EduGomesNascimento/VOASUL/drone/cad/molde_compensado.pdf

## Frame do drone VoaSul em compensado 3 mm: MOLDE 1:1

Linha cheia = corte | tracejado = referencia de colagem | cruz = centro do furo

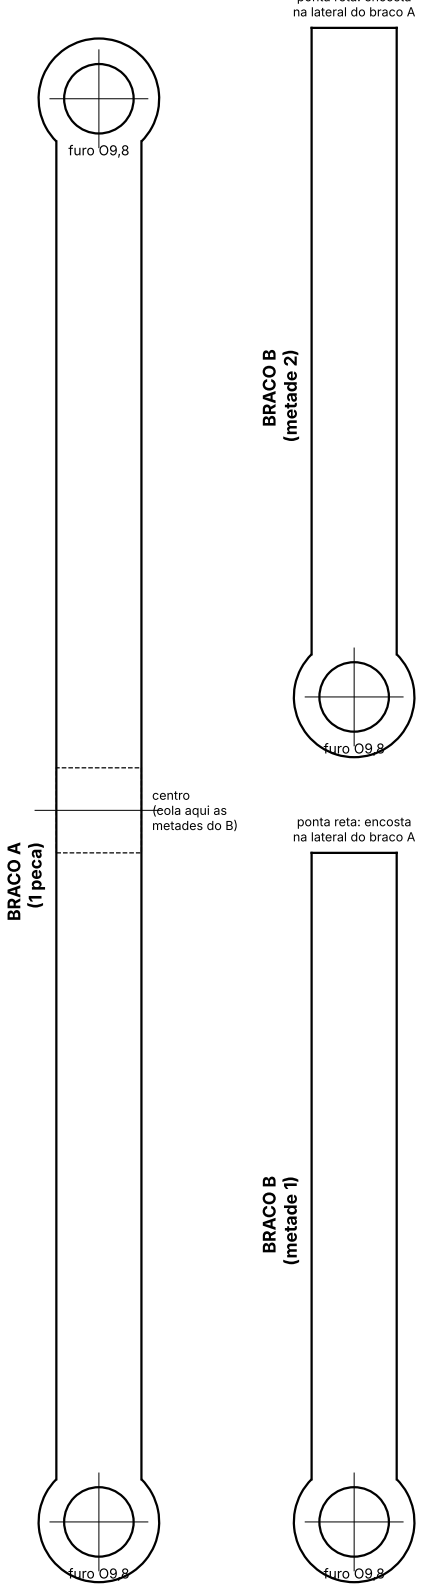
[picture p6: figure]
furo O9,8; centro (cola aqui as metades do B); BRACO A; (1 peca); ponta reta: encosta na lateral do braco A; BRACO B (metade 1); na lateral do braco A; BRACO B (metade 2)

0 | 50 | 100

REGUA 100 mm: confira com uma regua antes de cortar (impressao em 100%, sem "ajustar")

furo O9,8

ponta reta: encosta

FRENTE

PLACA DO CENTRO (cima)

FRENTE

PLACA DO CENTRO (baixo)

Chapa: compensado 3 mm
Peso estimado: ~12 g (+~1 g de cola) PLA atual: ~28 g

Motores a 100,4 mm do centro (diagonal motor-motor 200,8 mm) Furo do motor O9,8: broca de 10 mm e teste; folgado -> volta de fita

Cortar: 1 braco A, 2 metades B,
2 placas do centro
Montagem na pagina 2

# Montagem do frame de compensado

Desenho em ESCALA 1:2 (metade do tamanho real): use as medidas escritas, nao a regua

FRENTE (lado do MT3608 da placa)

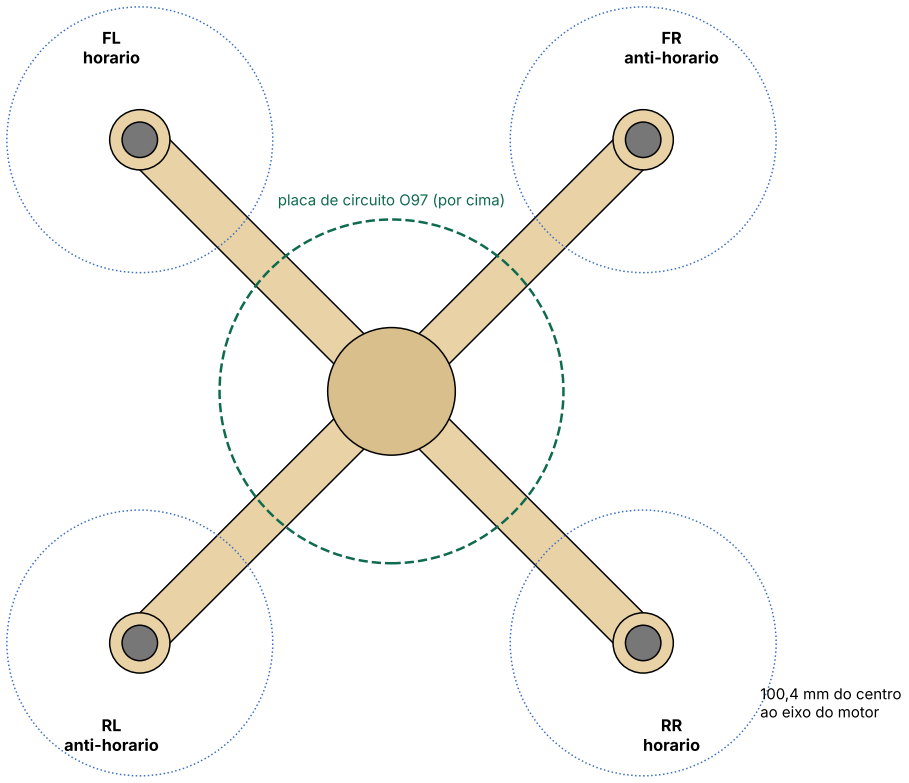
[picture p7: figure]
FR anti-horario; RR horario; RL anti-horario; FL horario; placa de circuito O97 (por cima); 100,4 mm do centro ao eixo do motor

Antes | Imprima a pagina 1 em 100% (A4, sem "ajustar a pagina") e confira a regua de 100 mm. Meca a chapa: o molde e para 3 mm; 4 mm tambem serve, so pesa mais.
1. Molde | Cole o papel na chapa com cola bastao. Fure ANTES de cortar (a peca ainda firme): broca fina de guia na cruz, depois a de 10 mm. Teste o motor: tem que entrar justo.
2. Corte | Serrinha tico-tico ou estilete forte, varias passadas. Corte por FORA da linha e lixe ate ela. As metades do braco B tem a ponta reta em esquadro: ela encosta na lateral do braco A.
3. Colagem | Mesa plana com papel-manteiga. Braco A no meio, as metades do B encostadas nele formando um X a 90 graus (use um esquadro). Cola de madeira ou epoxi na junta e nas duas placas do centro (em cima e embaixo, seguindo o tracejado). Peso em cima ate secar.
4. Conferir | Os 4 motores na MESMA altura e a mesma distancia do centro (diagonais iguais). Frame torto faz o drone girar sozinho.
5. Acabamento | Uma demao fina de verniz ou cola branca diluida: a madeira nao empena com umidade.
6. Motores | Encaixe nos furos (FR e RL anti-horario, RR e FL horario, vistos de cima). Fios por cima do braco com pontos de cola quente.
7. Placa | Sobre a placa do centro de cima, 2 camadas de fita espuma (~3 mm). A placa de circuito fica presa so no centro e SEM encostar nos bracos: embaixo dela, nas diagonais, ha soldas e os MOSFETs. Corte rente as pontas dos pinos embaixo da placa.
8. Bateria e pes | Bateria embaixo do cruzamento, com o velcro em volta do braco A. Pes: 4 pedacos de EVA ou espuma embaixo dos bracos, ~15 mm antes de cada motor.
