EduGomesNascimento/VOASUL/drone/kicad/saidas/folha_transferencia_A4.pdf

BC
COPIA 1

BC
COPIA 2

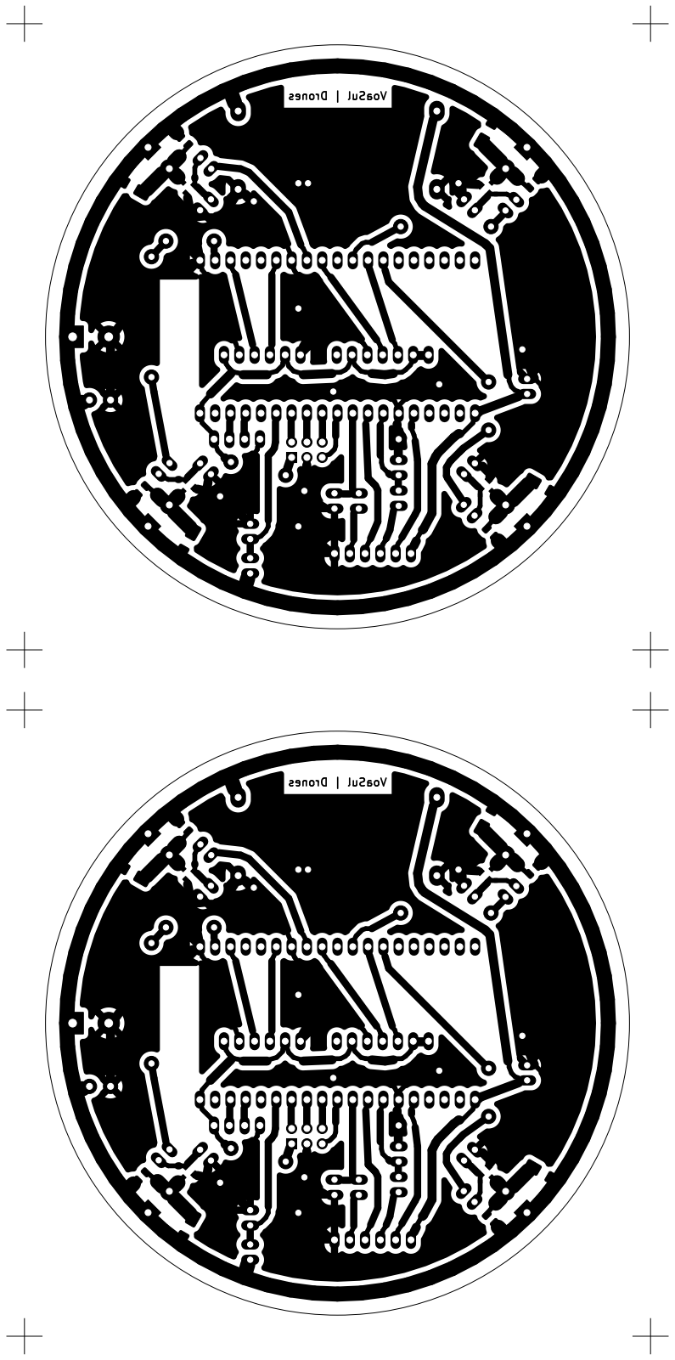
[picture p8: figure]

REGUA 100 mm - meca antes de passar o ferro (tem que dar 100 mm exatos)

DRONE VoaSul - folha de transferencia termica - cobre de baixo (face unica), 1:1
1) Impressora LASER, papel glossy/transferencia, escala 100% (desligue "ajustar a pagina").
2) NAO espelhe: o texto "VoaSul | Drones" da placa aparece AO CONTRARIO no papel - esta certo.
3) Toner virado para o cobre; ferro no algodao, 3-5 min apertando; agua 10 min; tire o papel.
4) Duas copias: use a 2a se a 1a falhar. Furos: 0,9 pinos | 1,0 motor/modulos | 1,3 bateria.
