EduGomesNascimento/VOASUL/drone/cad/frame_redondo.png

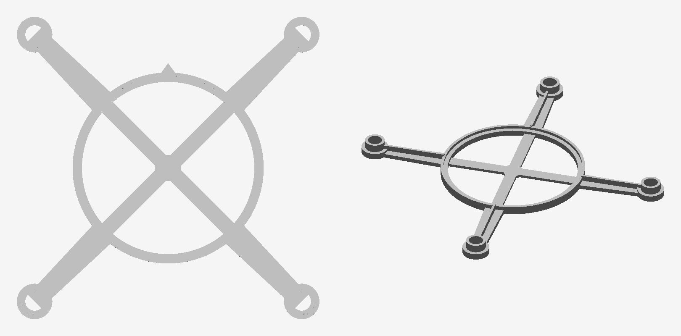
drone/cad/frame_redondo.png
