EduGomesNascimento/VOASUL/drone/docs/esquema.png

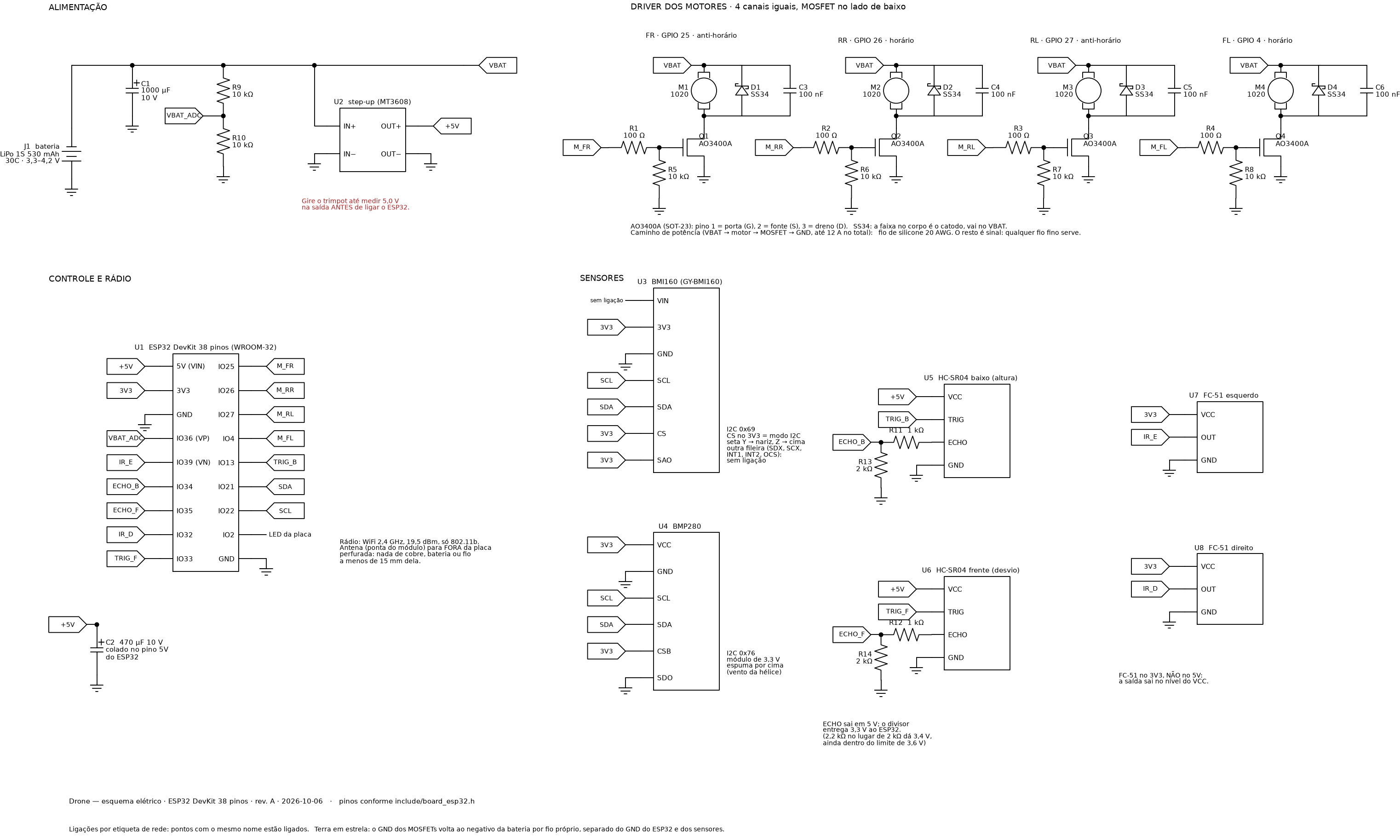
drone/docs/esquema.png
