EduGomesNascimento/VOASUL/drone/docs/layout_placa.png

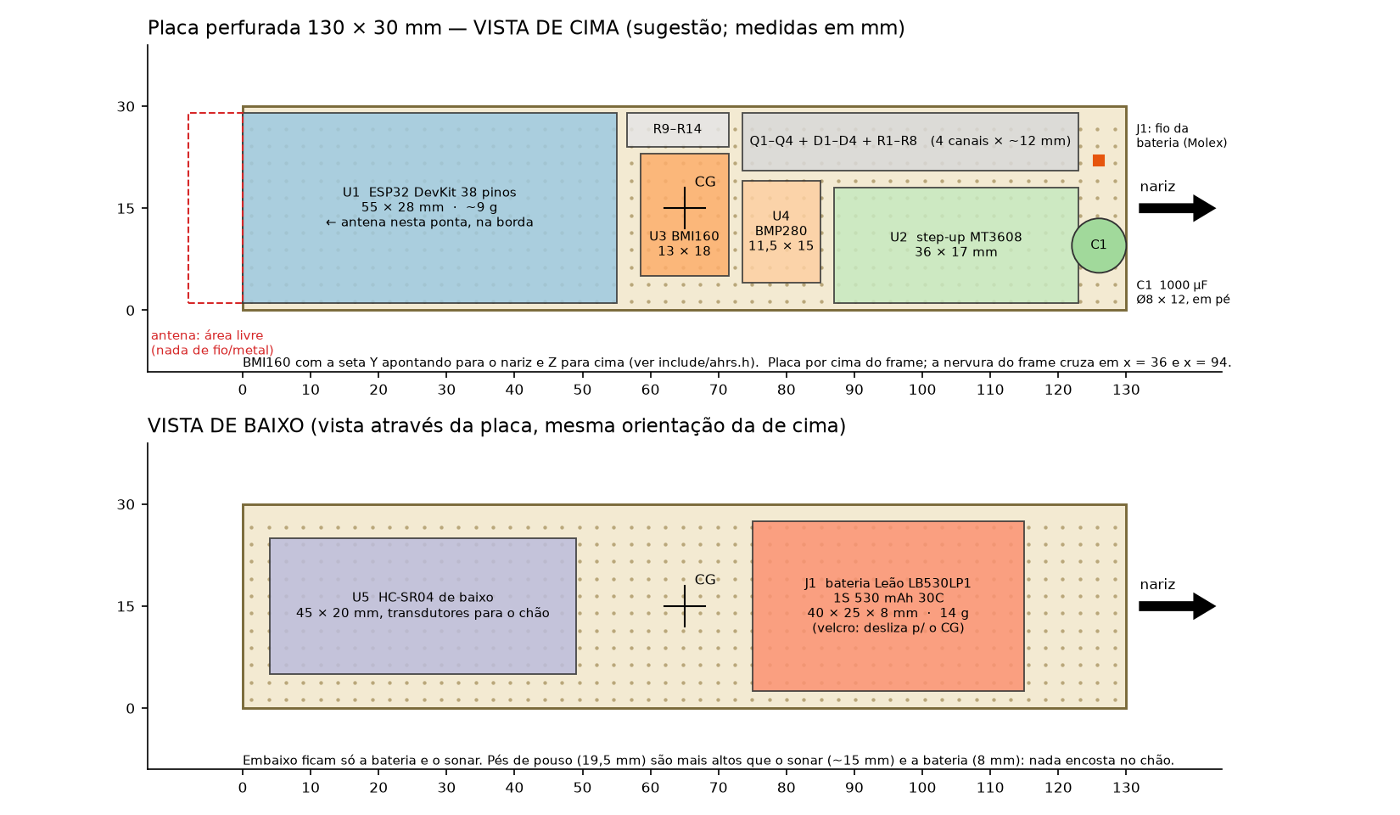
drone/docs/layout_placa.png
