EduGomesNascimento/VOASUL/drone/kicad/cnc/previa_cnc.png

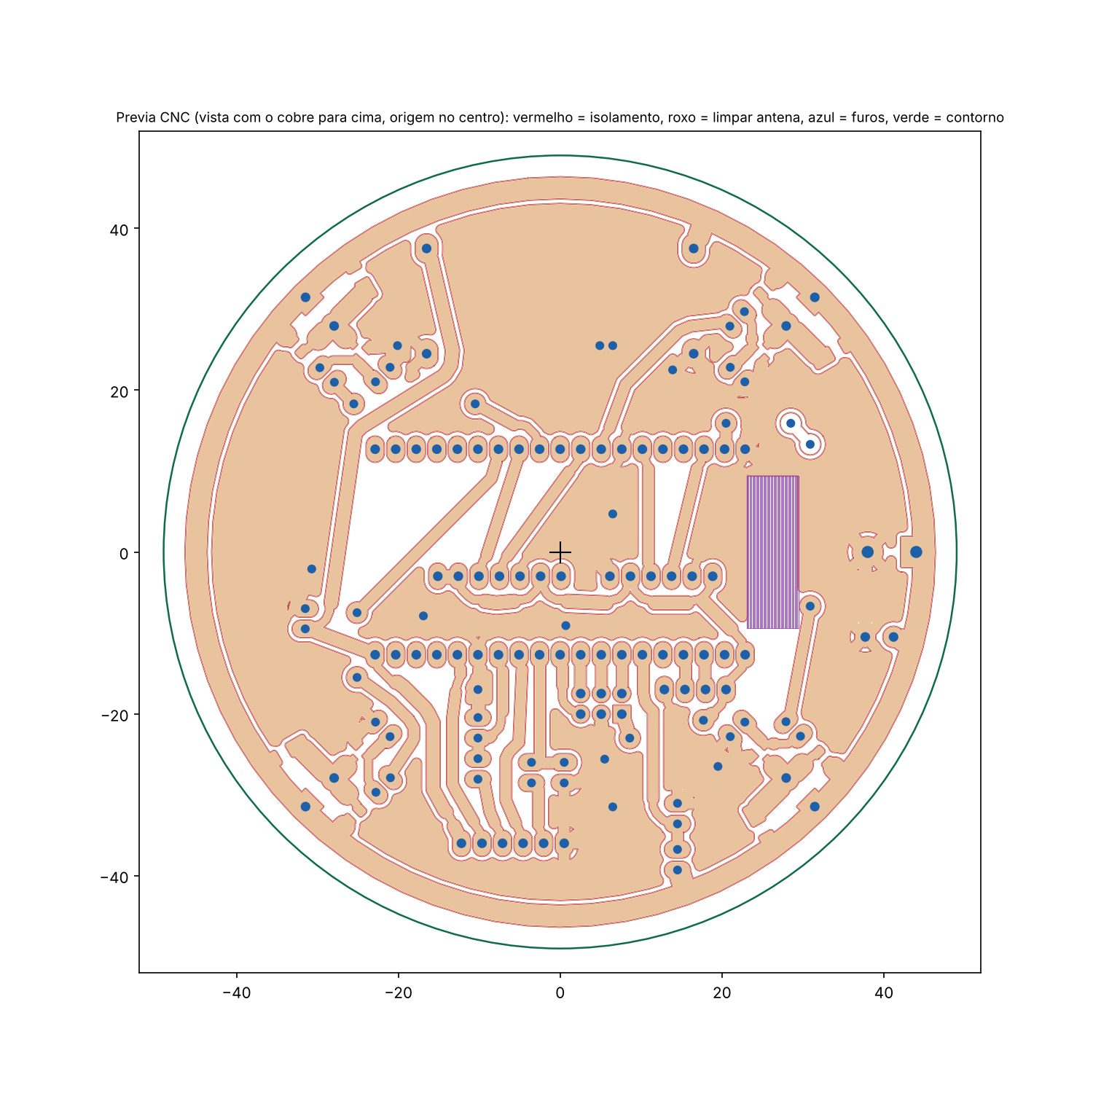
drone/kicad/cnc/previa_cnc.png
