EduGomesNascimento/VOASUL/drone/kicad/saidas/drone3d_baixo.png

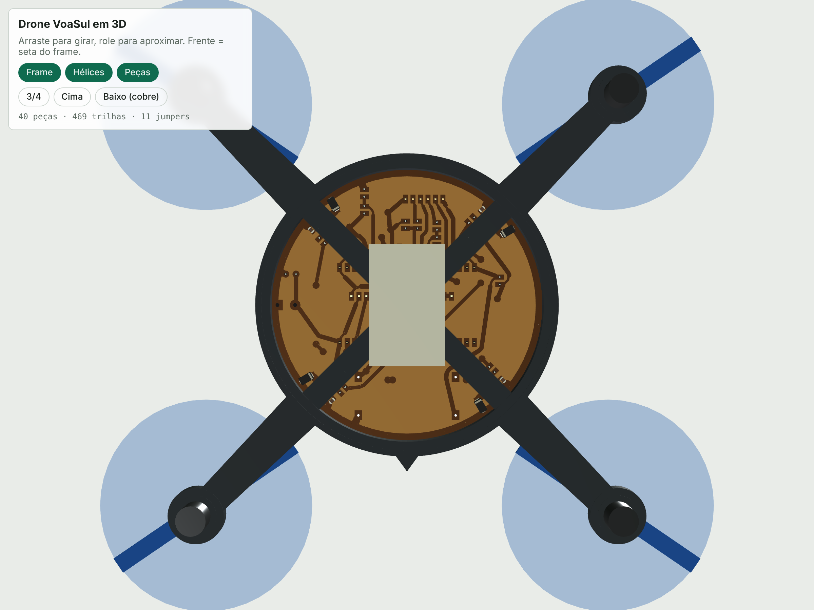
drone/kicad/saidas/drone3d_baixo.png
