EduGomesNascimento/VOASUL/drone/kicad/saidas/drone3d_cima.png

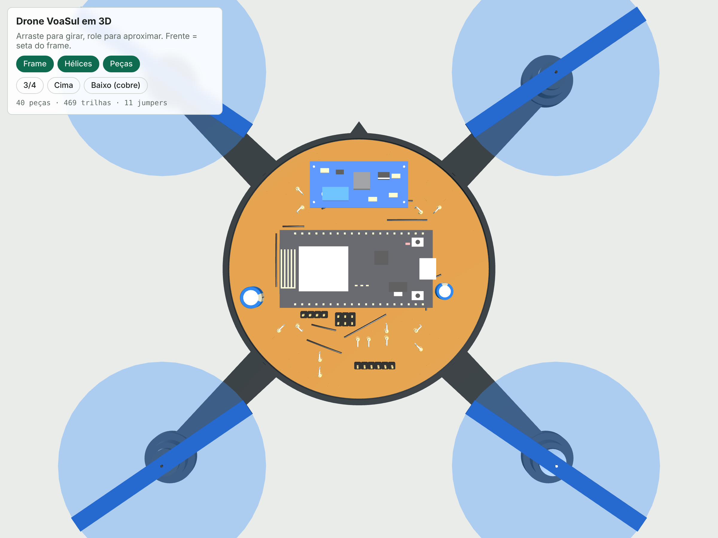
drone/kicad/saidas/drone3d_cima.png
