EduGomesNascimento/VOASUL/drone/kicad/saidas/drone3d_iso.png

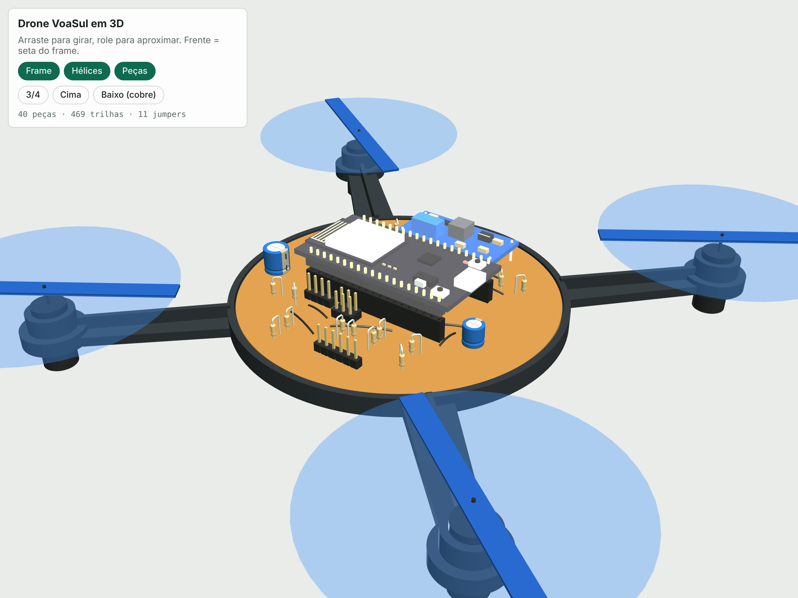
drone/kicad/saidas/drone3d_iso.png
