EduGomesNascimento/VOASUL/drone/kicad/pro/montagem_jlc/BOM_JLCPCB.csv

Comment | Designator | Footprint | LCSC Part #
100nF 0805 | C3,C4,C5,C6 | C_0805_2012Metric | C49678
SS34 | D1,D2,D3,D4 | D_SMA | C8678
AO3400A | Q1,Q2,Q3,Q4 | SOT-23 | C20917
