EduGomesNascimento/VOASUL/drone/cad/frame.stl

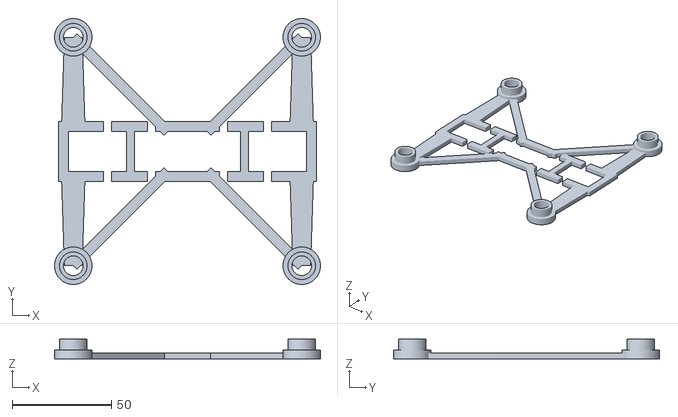
[picture p16: CAD file, 2026-11-03]
drone/cad/frame.stl
133.9 x 133.9 x 10.0
