EduGomesNascimento/VOASUL/drone/cad/original/DRONE_inventor.stl

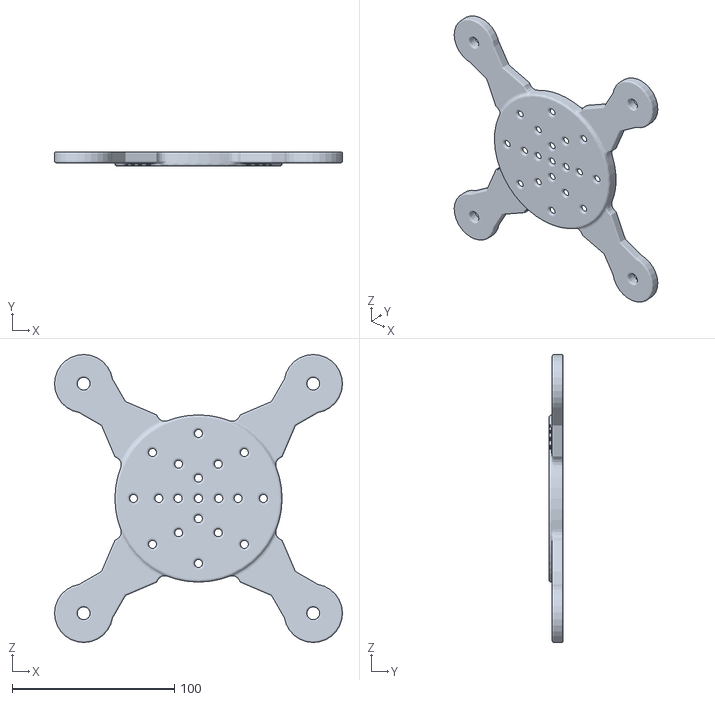
[picture p17: CAD file, 2026-11-03]
drone/cad/original/DRONE_inventor.stl
177.4 x 8.70 x 177.4
