EduGomesNascimento/VOASUL/drone/cad/placa_impressao.stl

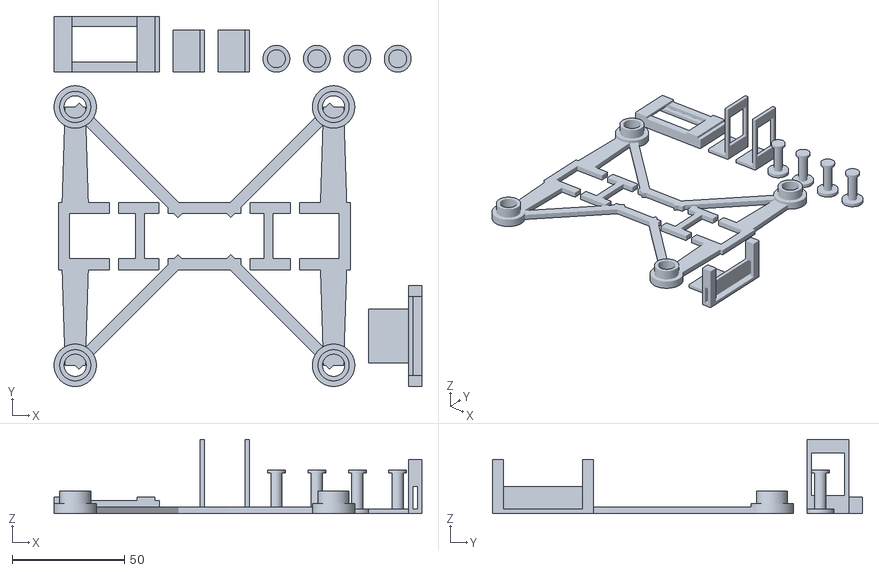
[picture p18: CAD file, 2026-11-03]
drone/cad/placa_impressao.stl
163.8 x 164.7 x 33.0
