EduGomesNascimento/VOASUL/drone/cad/helice_cw.stl

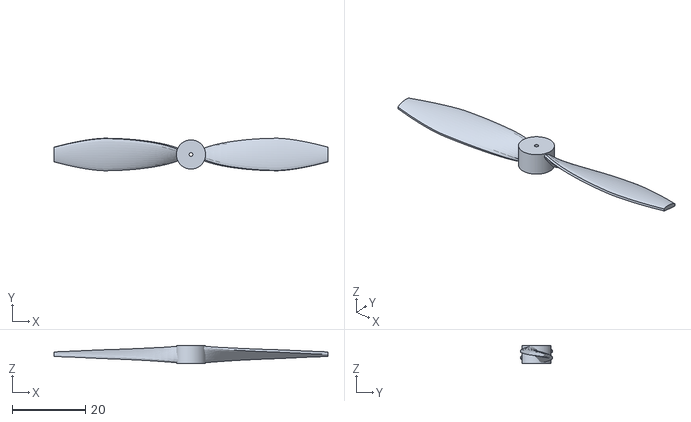
[picture p19: CAD file, 2026-11-03]
drone/cad/helice_cw.stl
75.0 x 8.92 x 5.00
