EduGomesNascimento/VOASUL/drone/cad/frame_redondo.stl

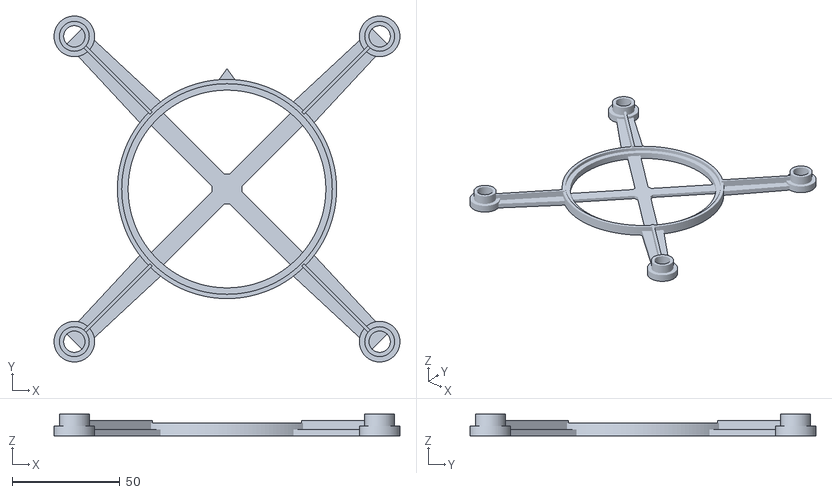
[picture p20: CAD file, 2026-11-03]
drone/cad/frame_redondo.stl
160.9 x 160.9 x 10.0
