EduGomesNascimento/VOASUL/drone/cad/sonar_frente.stl

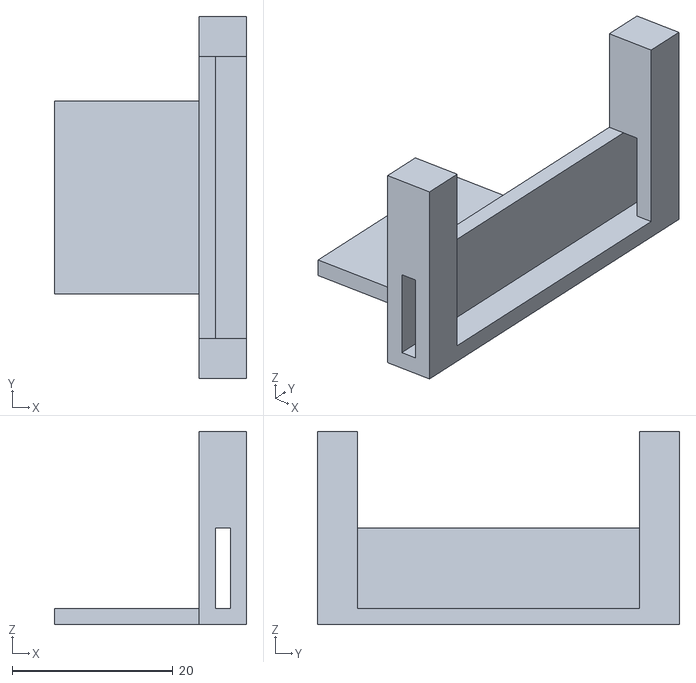
[picture p21: CAD file, 2026-11-03]
drone/cad/sonar_frente.stl
23.9 x 45.0 x 24.0
