EduGomesNascimento/VOASUL/drone/cad/placa_tudo.stl

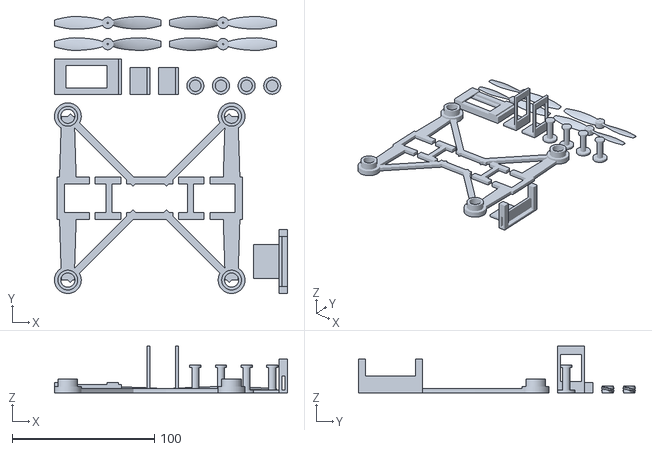
[picture p22: CAD file, 2026-11-03]
drone/cad/placa_tudo.stl
163.8 x 194.5 x 33.0
