EduGomesNascimento/VOASUL/drone/cad/pe.stl

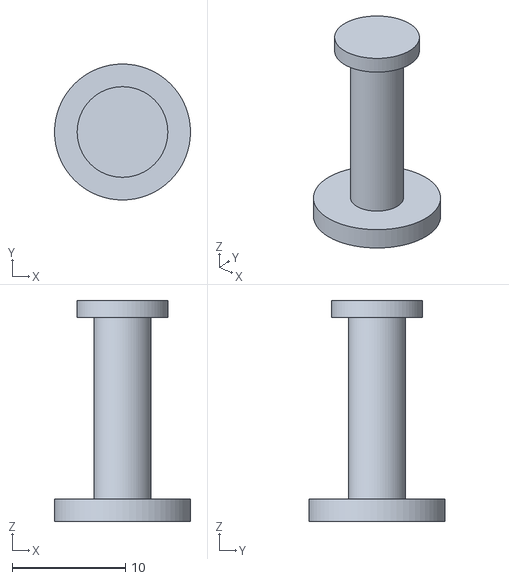
[picture p23: CAD file, 2026-11-03]
drone/cad/pe.stl
12.0 x 12.0 x 19.5
