EduGomesNascimento/VOASUL/drone/cad/sonar_baixo.stl

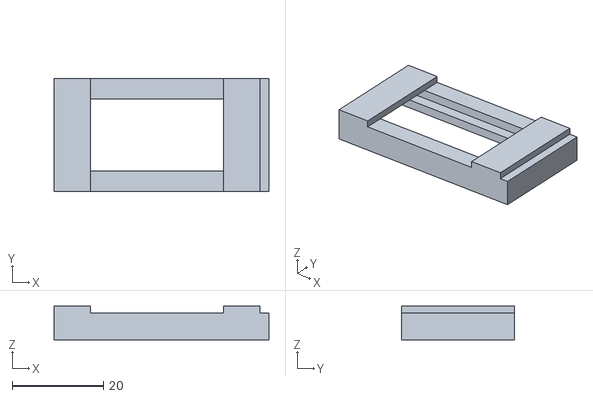
[picture p24: CAD file, 2026-11-03]
drone/cad/sonar_baixo.stl
47.0 x 24.8 x 7.40
