EduGomesNascimento/VOASUL/drone/cad/frame_minimo.stl

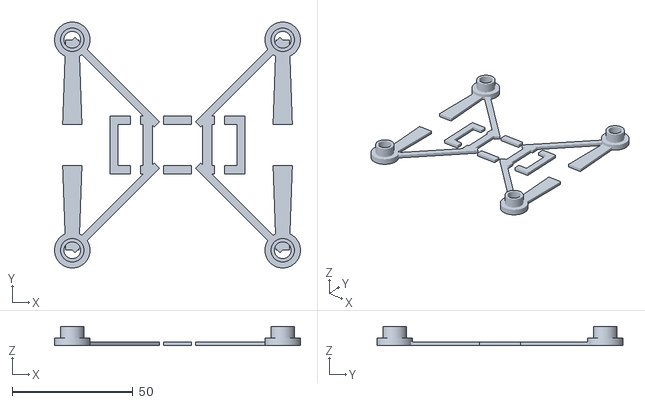
[picture p25: CAD file, 2026-11-03]
drone/cad/frame_minimo.stl
101.7 x 101.7 x 8.00
