EduGomesNascimento/VOASUL/drone/cad/frame_guardas.stl

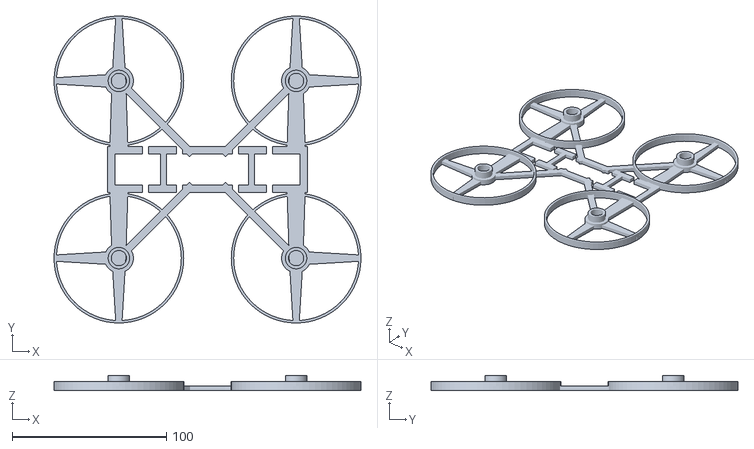
[picture p26: CAD file, 2026-11-03]
drone/cad/frame_guardas.stl
199.2 x 199.2 x 10.0
