EduGomesNascimento/VOASUL/drone/cad/suporte_ir.stl

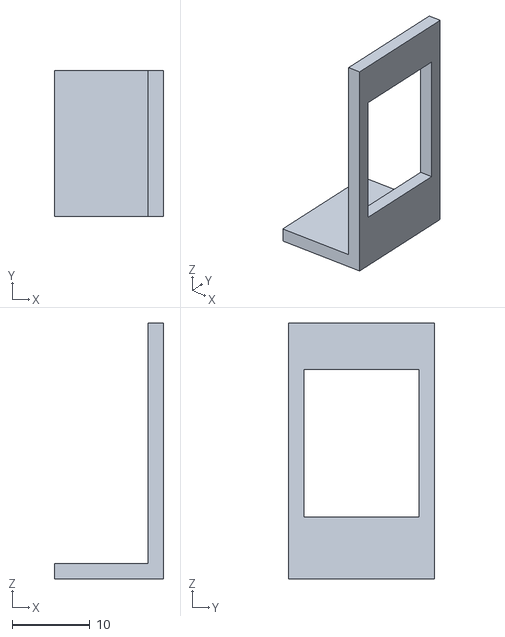
[picture p27: CAD file, 2026-11-03]
drone/cad/suporte_ir.stl
14.0 x 18.8 x 33.0
