EduGomesNascimento/VOASUL/(list of files, cad)

Other CAD files:
drone/kicad/saidas/frame_redondo.stl
drone/cad/helice_ccw.stl
