EduGomesNascimento/VOASUL/drone/kicad/saidas/montagem_baixo_vista_por_baixo.pdf

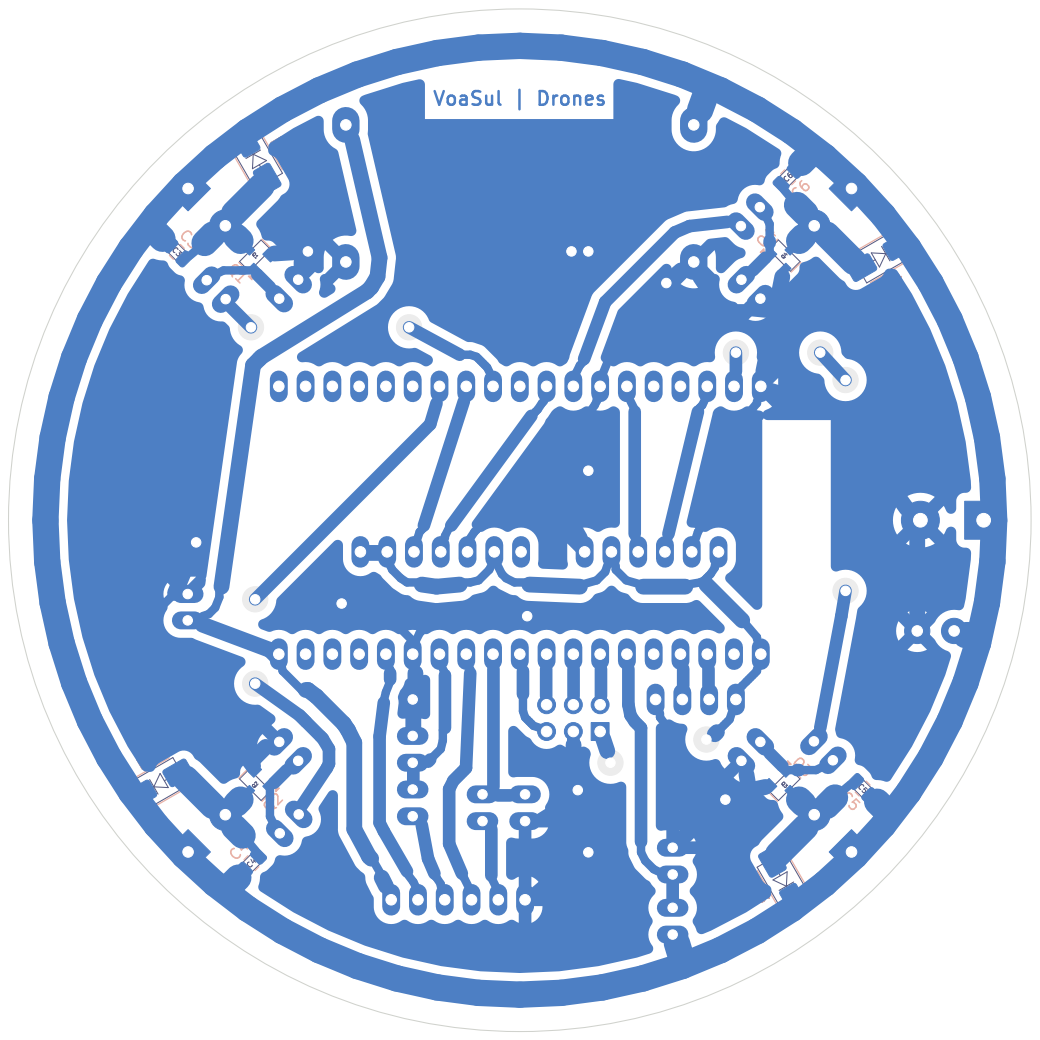
[picture p30: page 1]

Id: 1/1 Title: File: drone.kicad_pcb Sheet:
