EduGomesNascimento/VOASUL/drone/kicad/saidas/montagem_cima.pdf

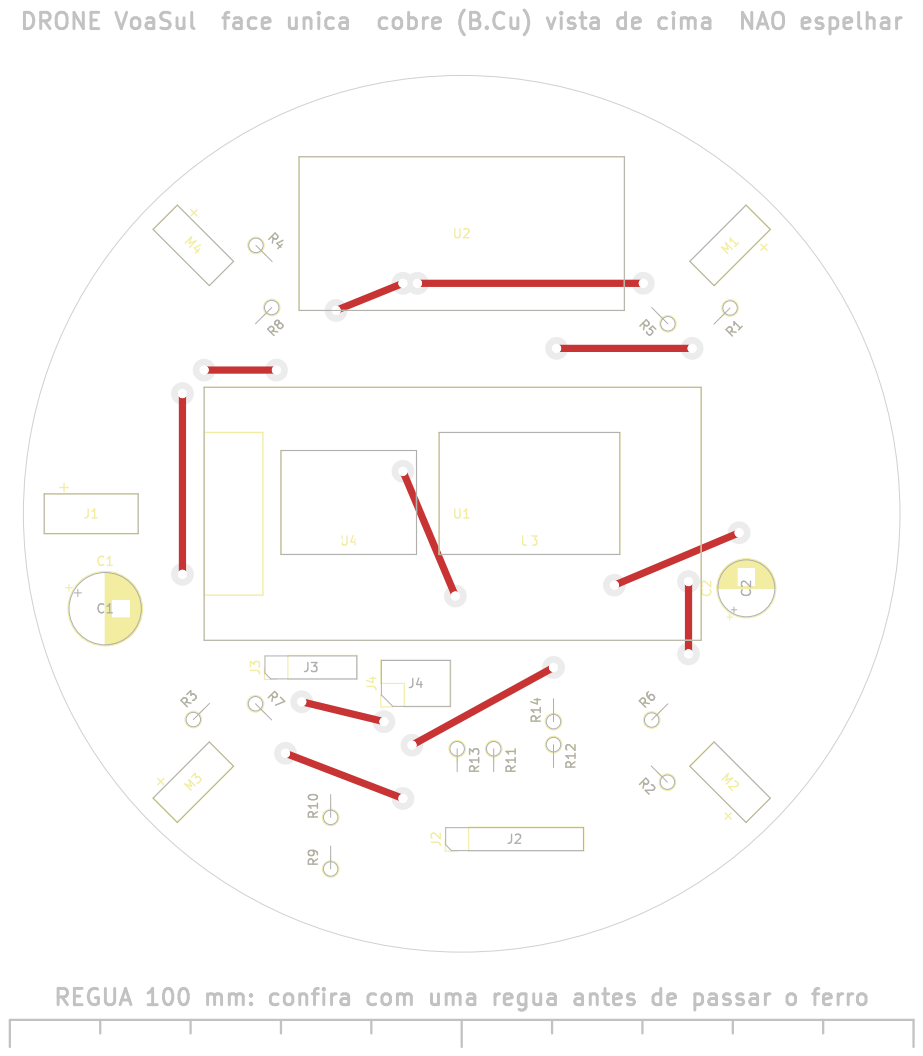
[picture p31: page 1]

Id: 1/1 Title: File: drone.kicad_pcb Sheet:
