EduGomesNascimento/VOASUL/drone/pcb/proteus/DRONE_COM_BORDA_COMPONENTES.pdf

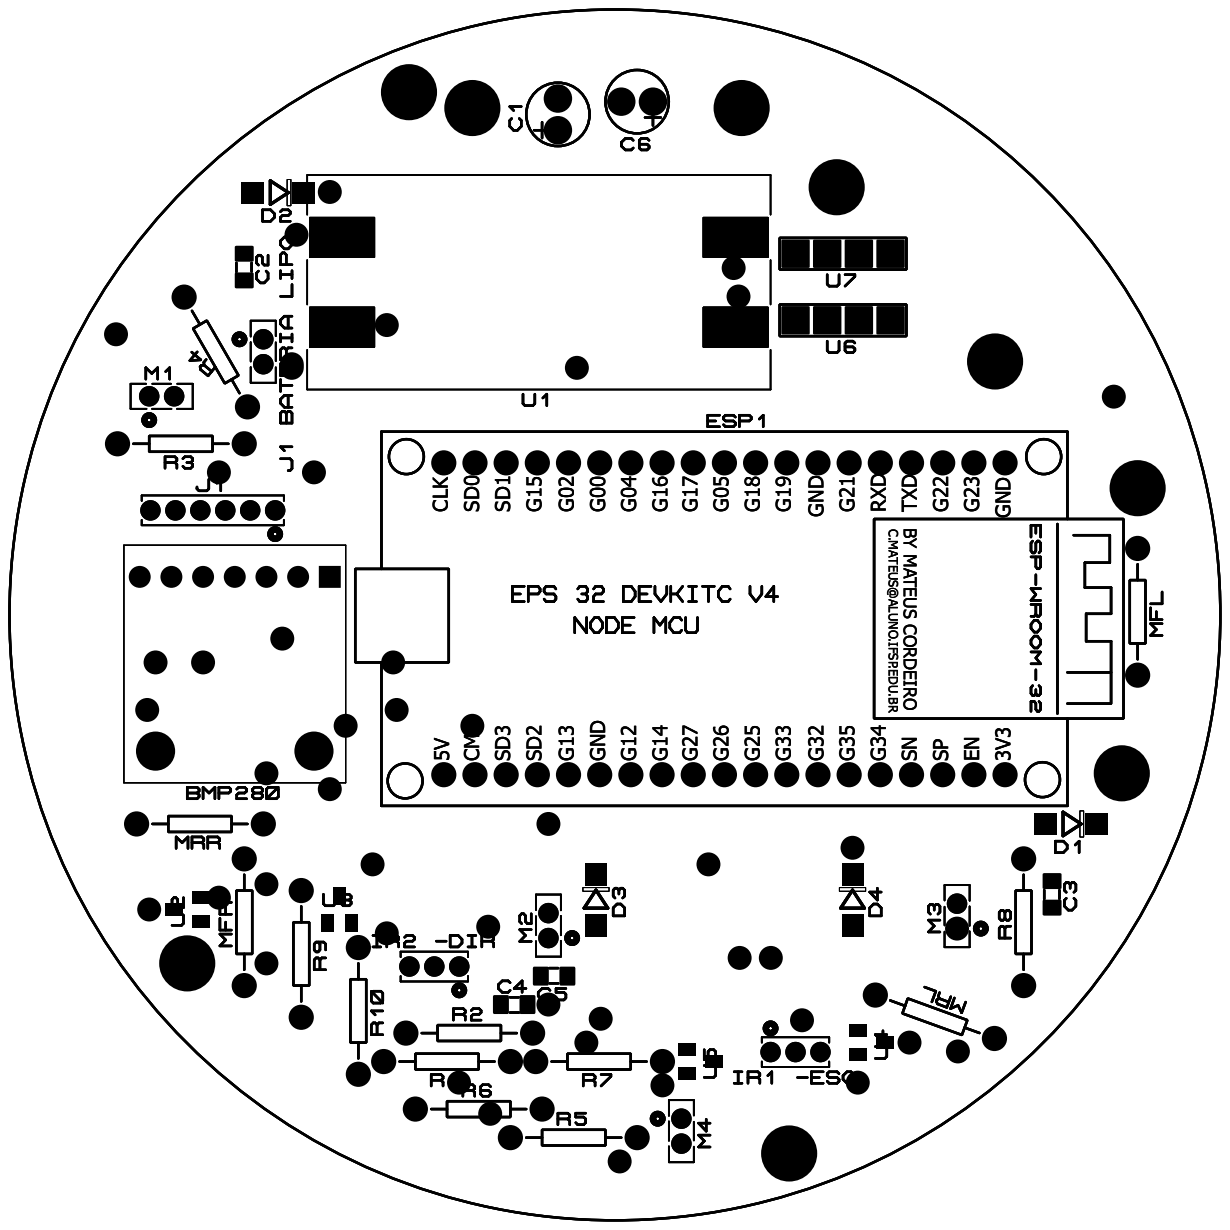
[picture p32: page 1]

5VCMD SD3 SD2 G13 GND G12 G14 G27 G26 G25 G33 G32 G35 G34 SNSPEN3V3 CLK SD0 SD1 G15 G02 G00 G04 G16 G17 G05 G18 G19 GND G21 RXD TXD G22 G23 GND BY MATEUS CORDEIRO C.MATEUS@ALUNO.IFSP.EDU.BR 5VCMD SD3 SD2 G13 GND G12 G14 G27 G26 G25 G33 G32 G35 G34 SNSPEN3V3 CLK SD0 SD1 G15 G02 G00 G04 G16 G17 G05 G18 G19 GND G21 RXD TXD G22 G23 GND BY MATEUS CORDEIRO C.MATEUS@ALUNO.IFSP.EDU.BR 5VCMD SD3 SD2 G13 GND G12 G14 G27 G26 G25 G33 G32 G35 G34 SNSPEN3V3 CLK SD0 SD1 G15 G02 G00 G04 G16 G17 G05 G18 G19 GND G21 RXD TXD G22 G23 GND BY MATEUS CORDEIRO C.MATEUS@ALUNO.IFSP.EDU.BR
