EduGomesNascimento/VOASUL/drone/kicad/saidas/esquema.pdf

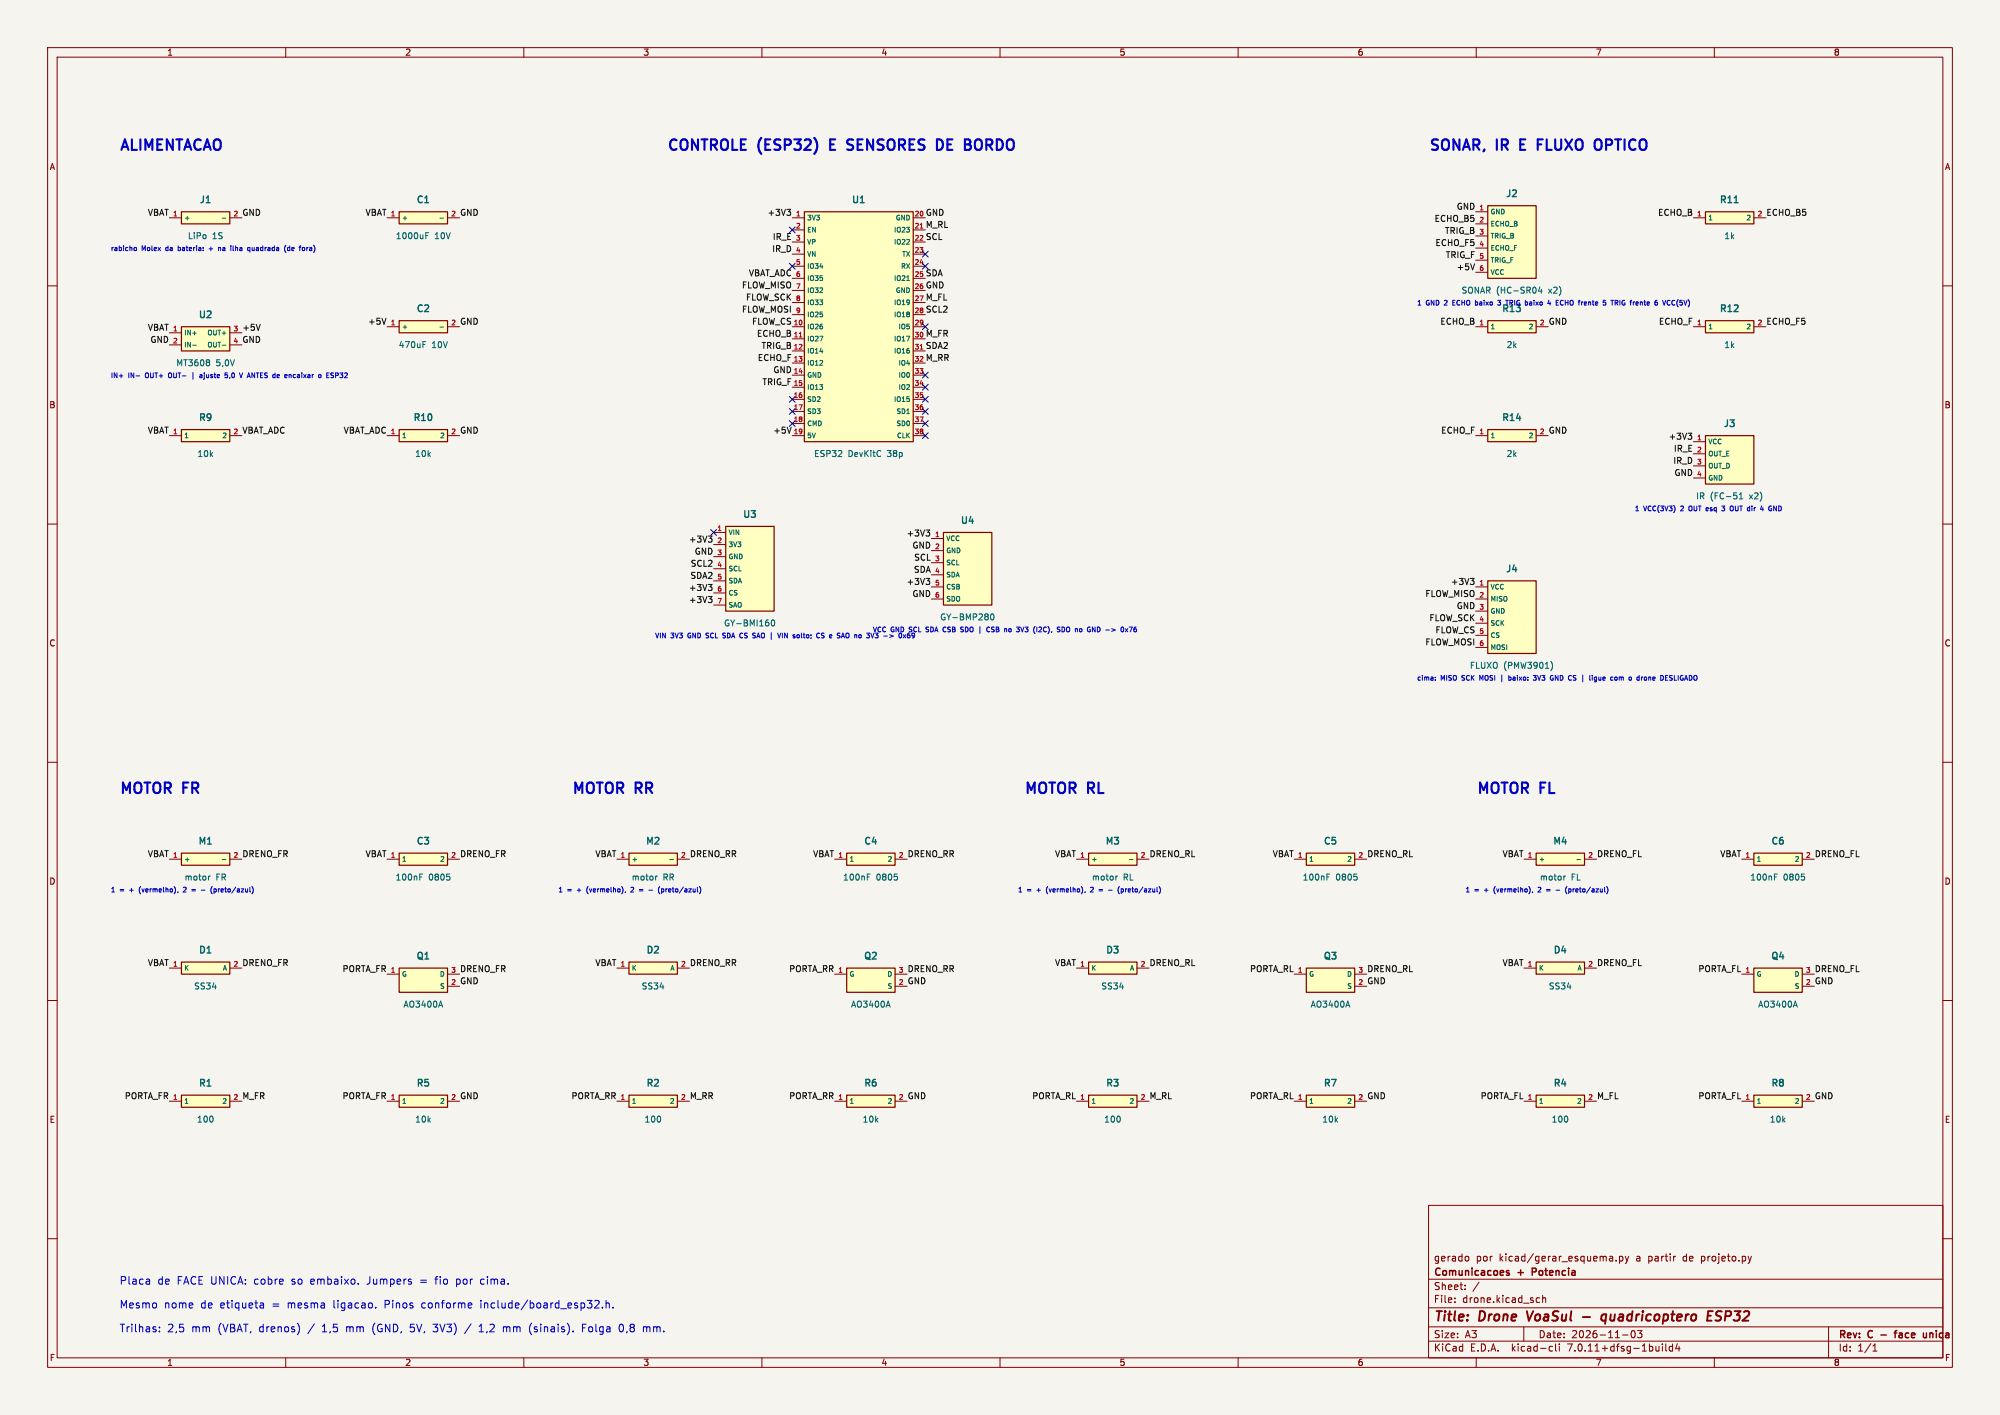
[picture p35: page 1]

1 GND 2 ECHO baixo 3 TRIG baixo 4 ECHO frente 5 TRIG frente 6 VCC(5V) 1 VCC(3V3) 2 OUT esq 3 OUT dir 4 GND

cima: MISO SCK MOSI | baixo: 3V3 GND CS | ligue com o drone DESLIGADO

Placa de FACE UNICA: cobre so embaixo. Jumpers = fio por cima.
