EduGomesNascimento/VOASUL/drone/kicad/saidas/transferencia_B_Cu.pdf

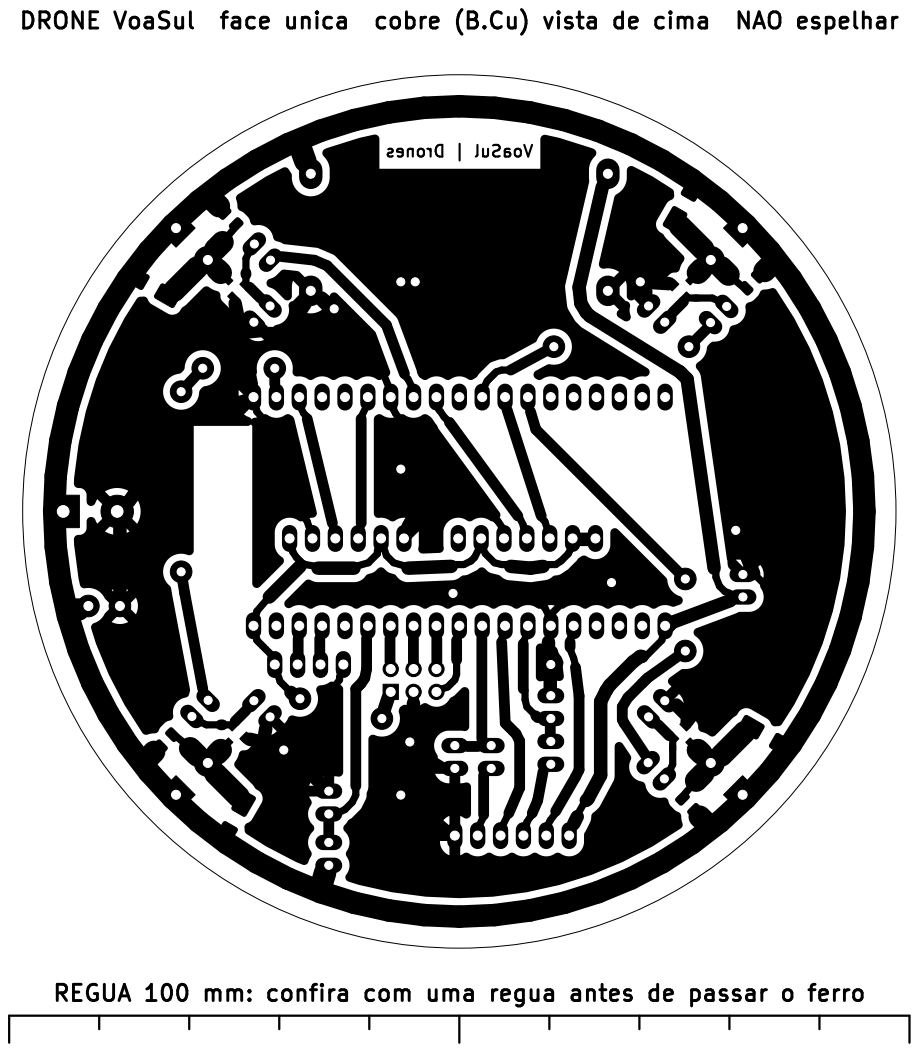
[picture p36: page 1]

Id: 1/1 Title: File: drone.kicad_pcb Sheet:
