EduGomesNascimento/VOASUL/drone/kicad/usinagem/gerber/previa_cobre_de_baixo.pdf

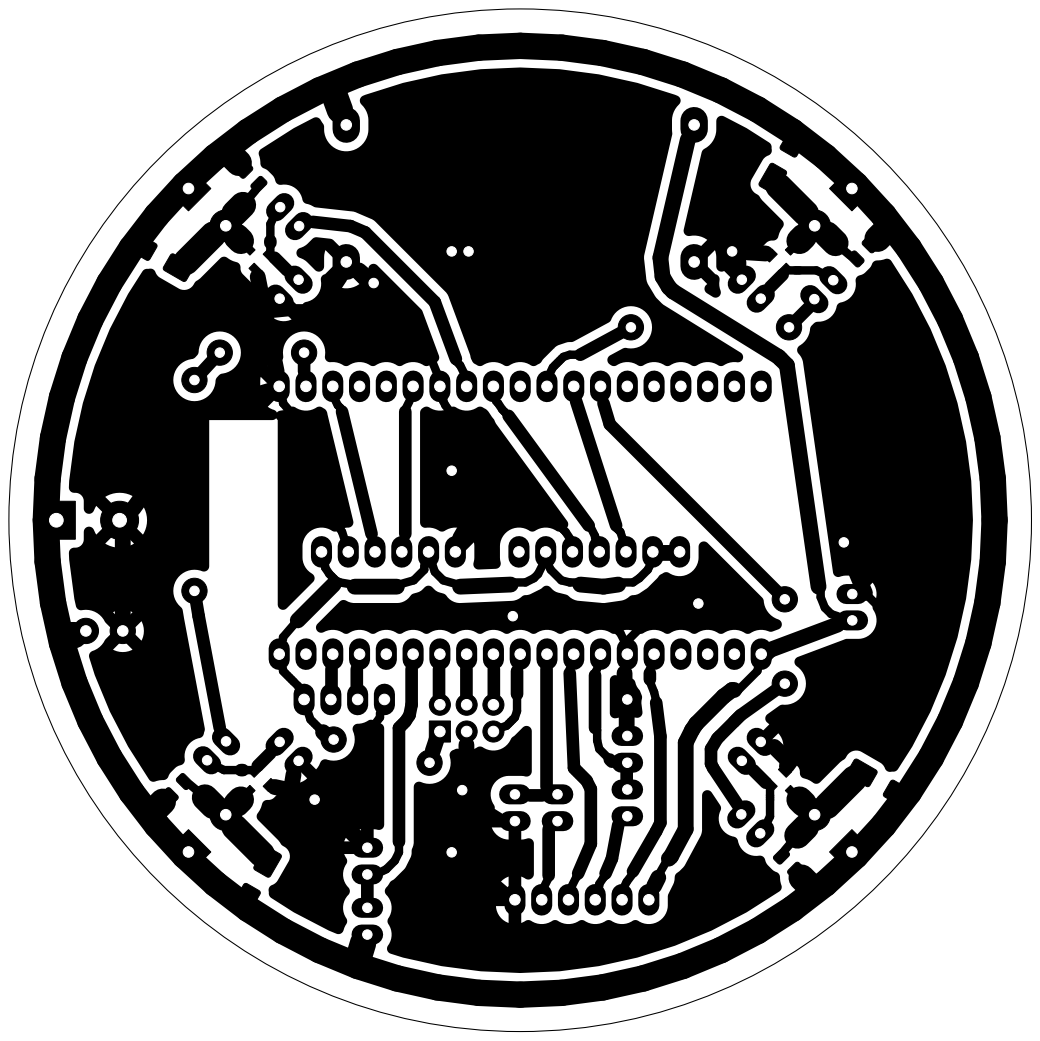
[picture p37: page 1]

Id: 1/1 Title: File: drone_usinagem.kicad_pcb Sheet:
