EduGomesNascimento/VOASUL/drone/pcb/proteus/DRONE_BOTTOM.pdf

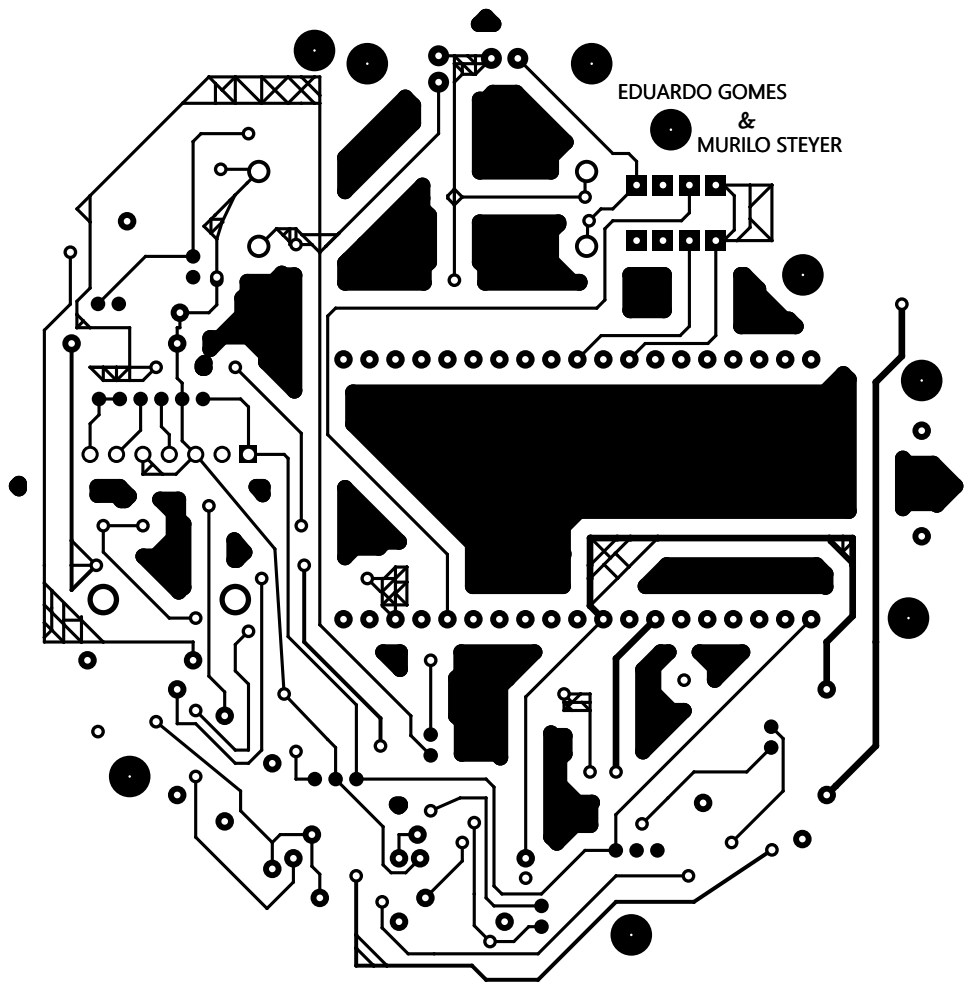
[picture p39: page 1]

EDUARDO GOMES MURILO STEYER &
