EduGomesNascimento/VOASUL/drone/pcb/proteus/DRONE_COM_BORDA_BOTTOM.pdf

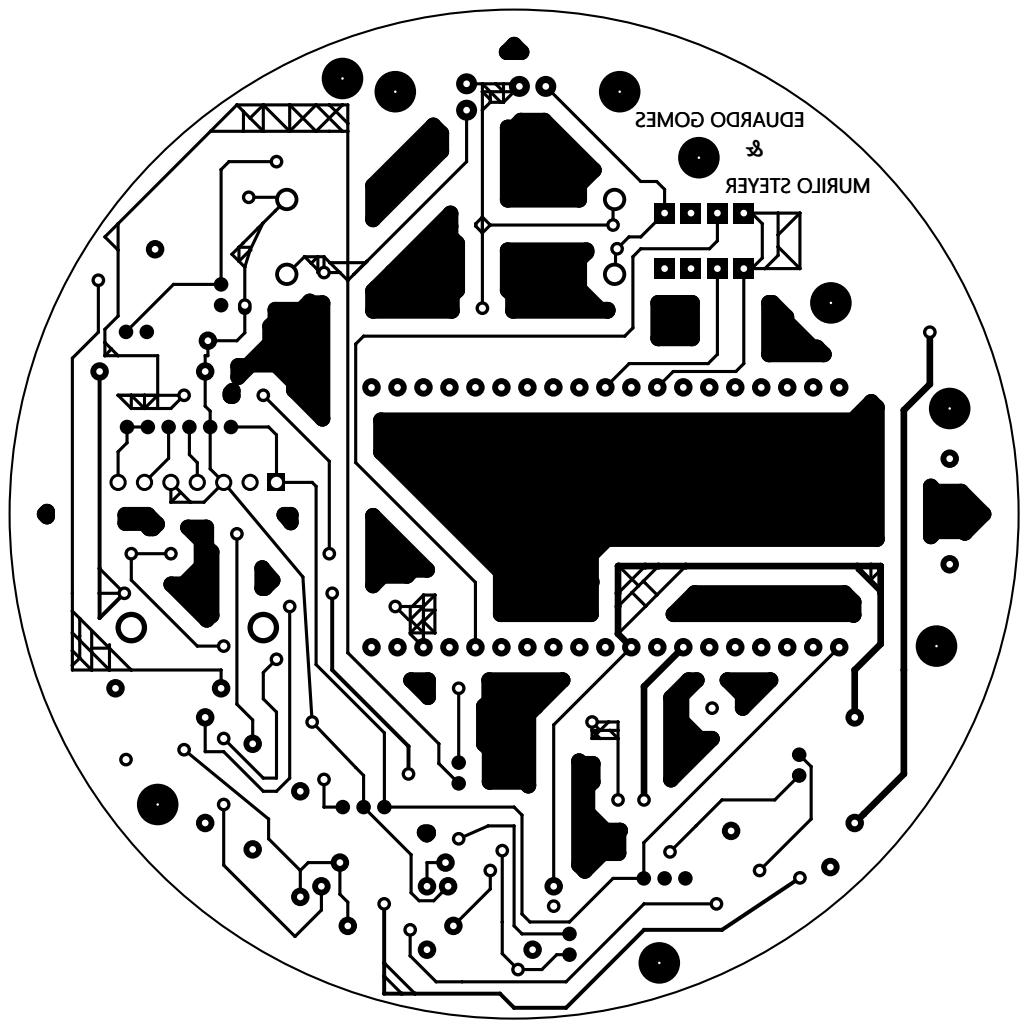
[picture p40: page 1]

SE MOG ODRAUDE REYETS OLI RUM &
