EduGomesNascimento/VOASUL/drone/pcb/proteus/DRONE_COM_BORDA_TOP.pdf

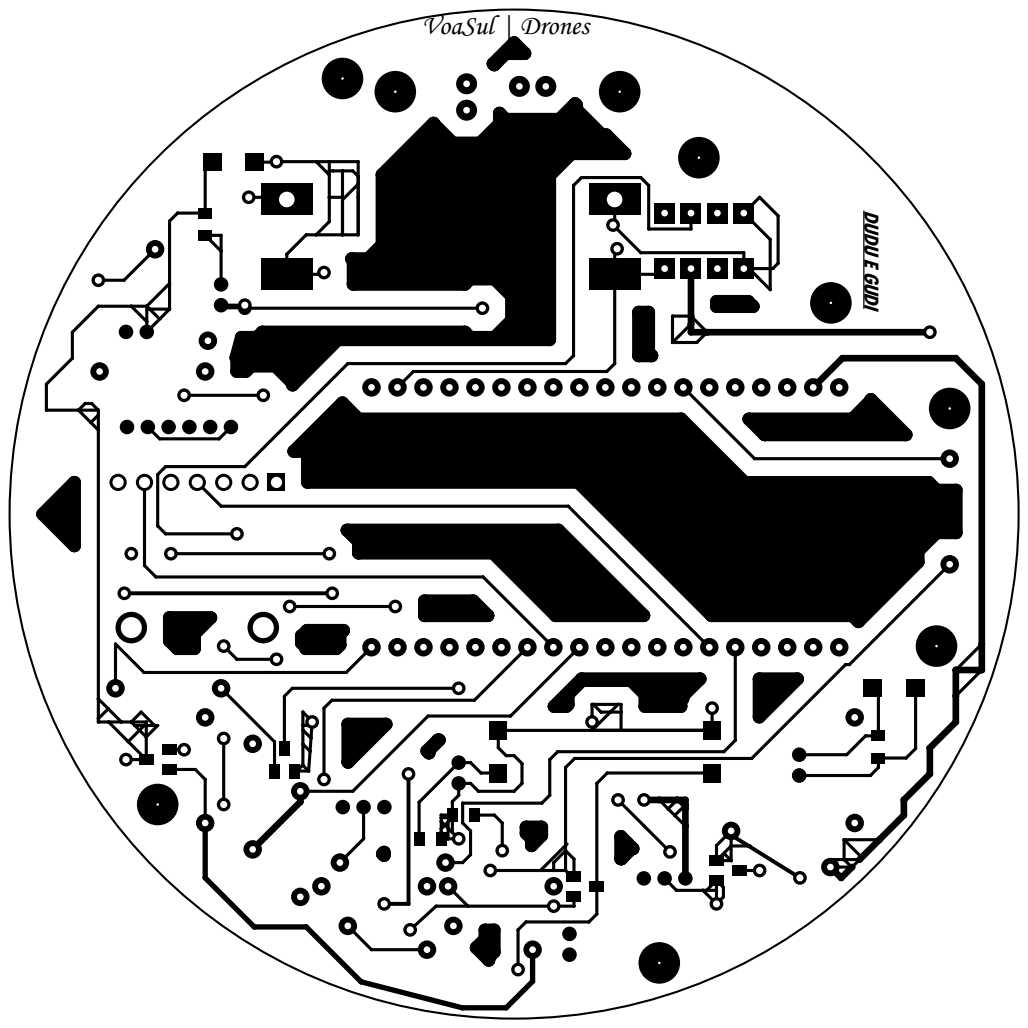
[picture p41: page 1]
