EduGomesNascimento/VOASUL/drone/pcb/proteus/DRONE_TOP.pdf

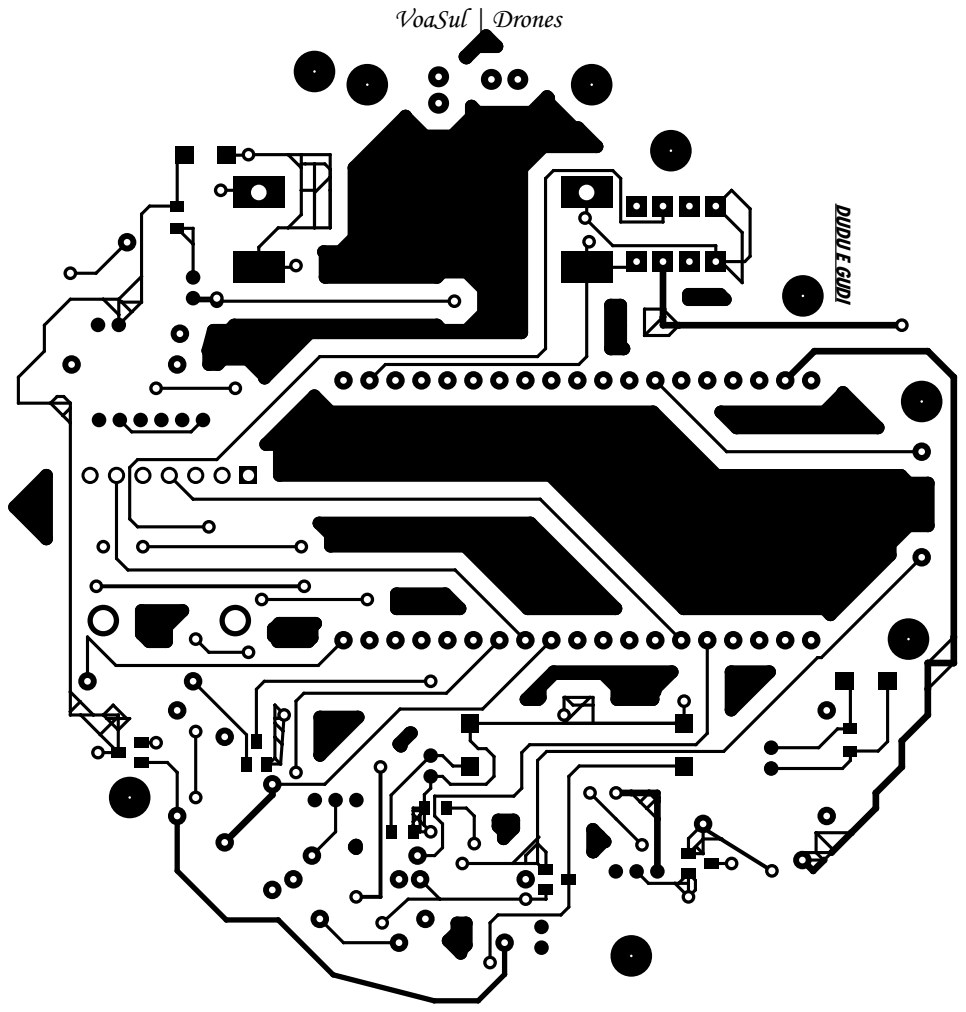
[picture p42: page 1]
