EduGomesNascimento/VOASUL/drone/kicad/drone.kicad_pcb

## KiCad design drone/kicad/drone.kicad_pcb (2026-11-05)

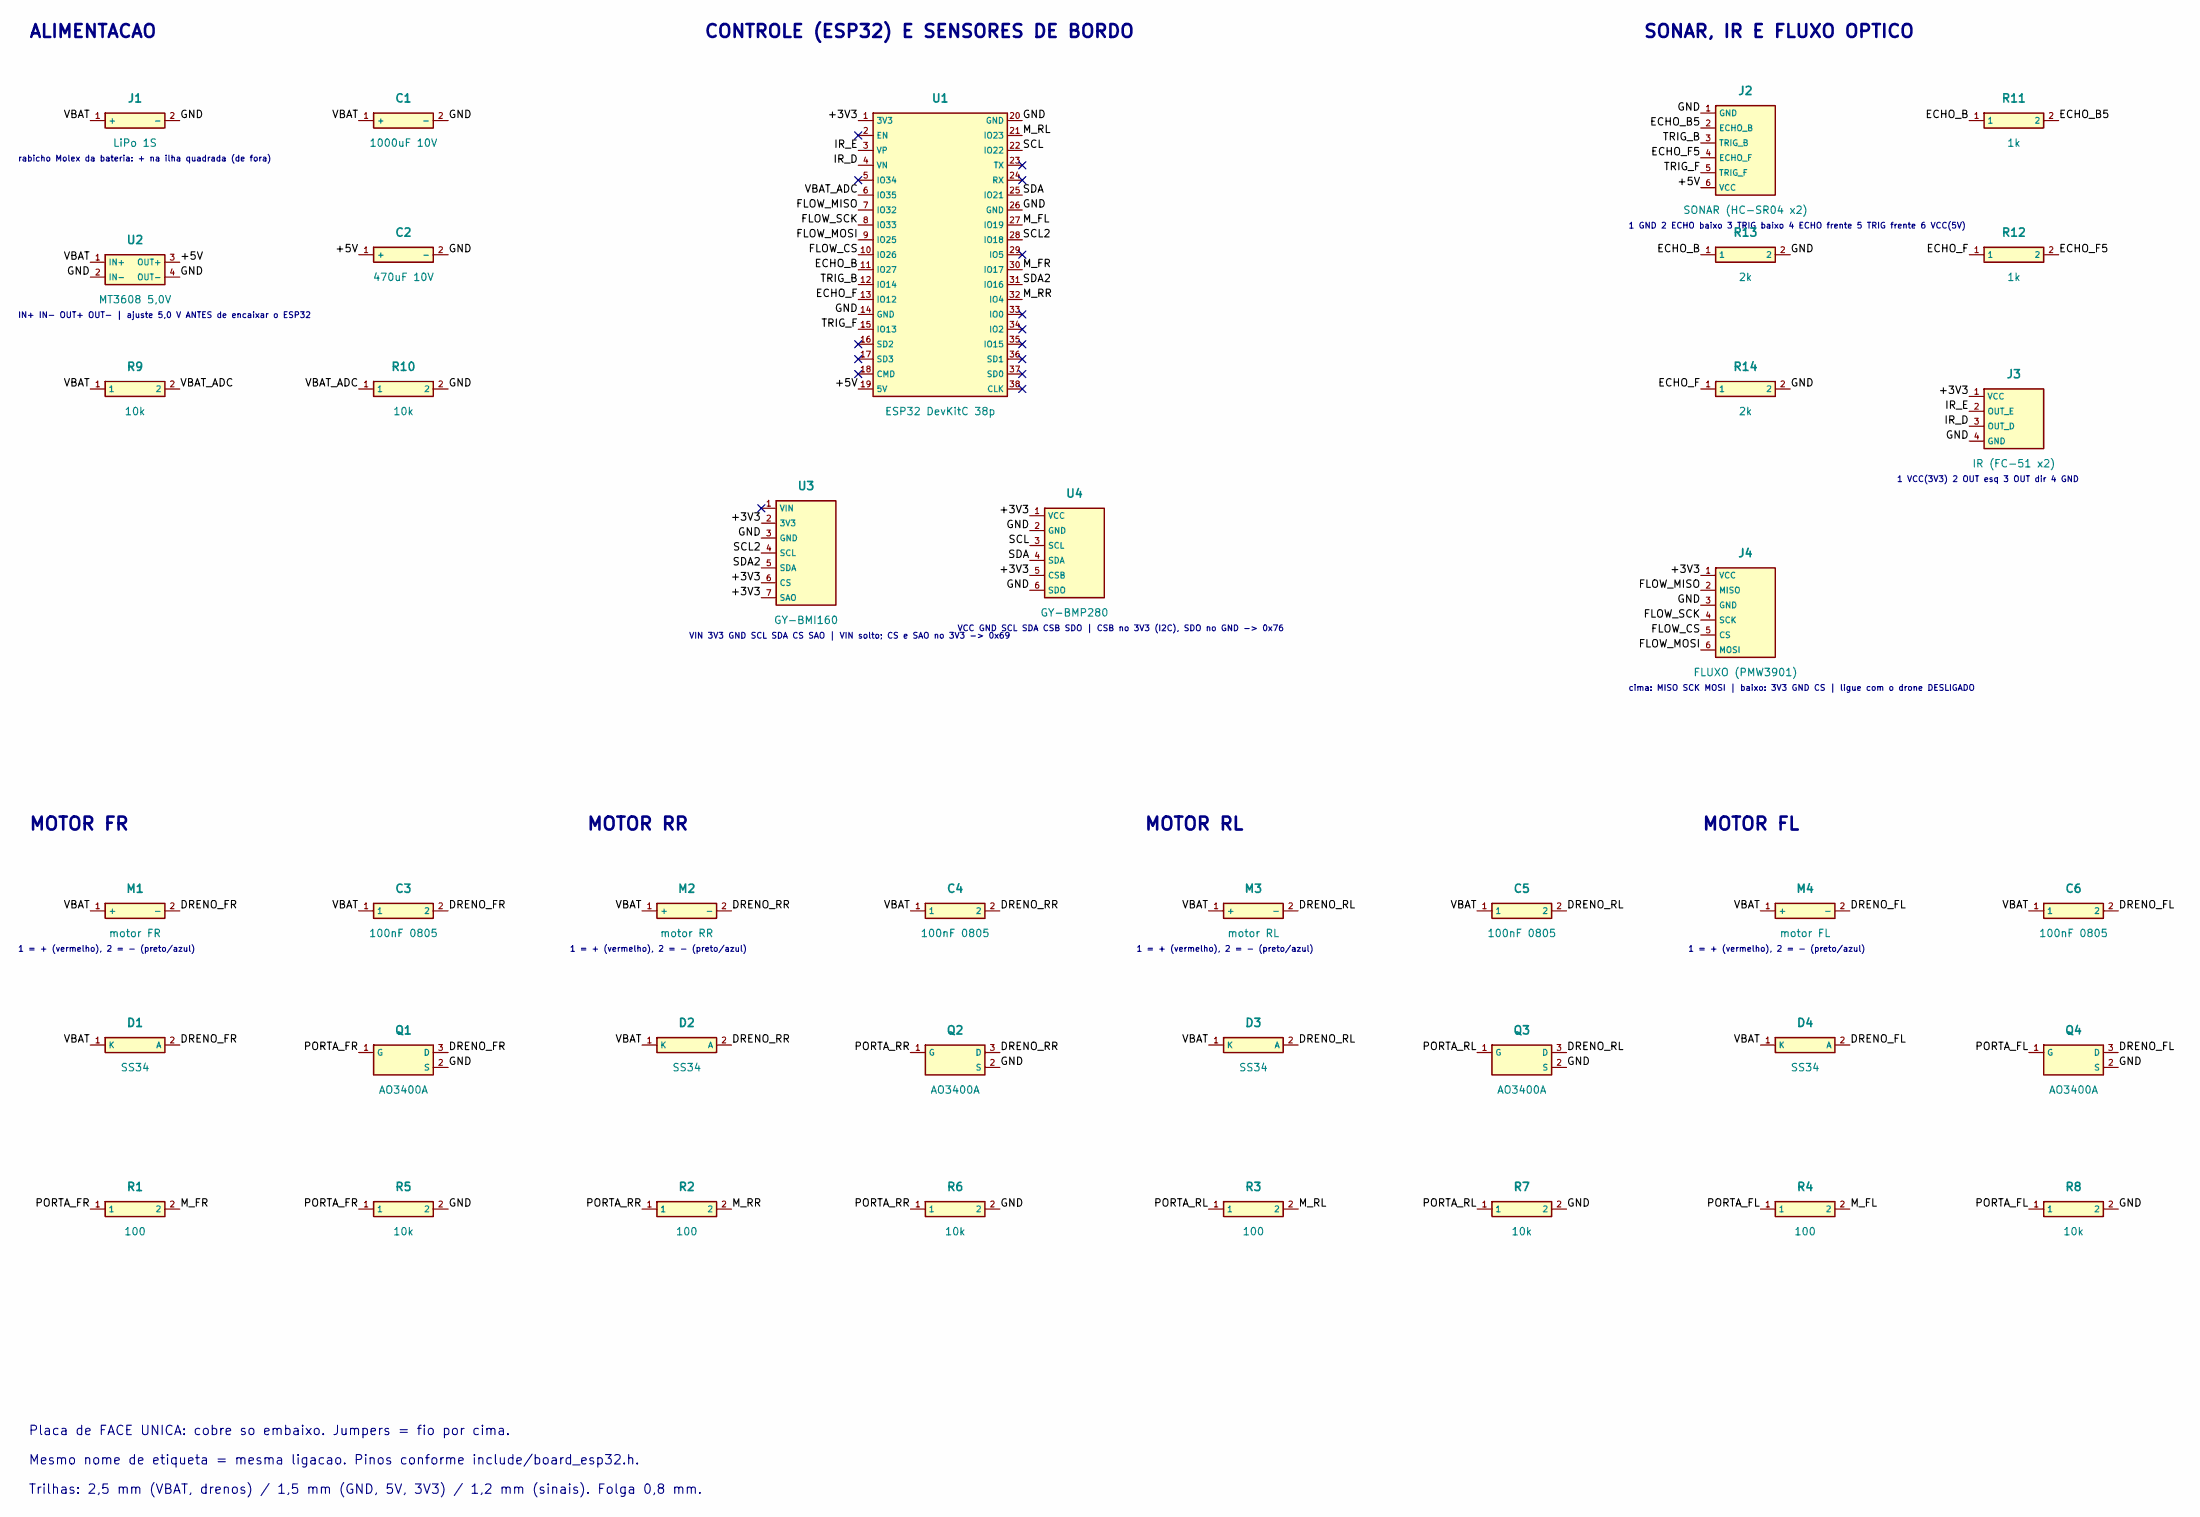
[picture p43: schematic drone.kicad_sch, Drone VoaSul - quadricoptero ESP32]

Parts:
C1: 1000uF 10V; CP_Radial_D8.0mm_P3.50mm
C2: 470uF 10V; CP_Radial_D6.3mm_P2.50mm
C3, C4, C5, C6: 100nF 0805; C_0805_2012Metric
D1, D2, D3, D4: SS34; D_SMA
J1: LiPo 1S; Ilhas_bateria
J2: SONAR (HC-SR04 x2); PinHeader_1x06_P2.54mm_Vertical
J3: IR (FC-51 x2); PinHeader_1x04_P2.54mm_Vertical
J4: FLUXO (PMW3901); PinHeader_2x03_P2.54mm_Vertical
M1: motor FR; Ilhas_motor
M2: motor RR; Ilhas_motor
M3: motor RL; Ilhas_motor
M4: motor FL; Ilhas_motor
Q1, Q2, Q3, Q4: AO3400A; SOT-23
R1, R2, R3, R4: 100; R_Axial_DIN0204_L3.6mm_D1.6mm_P2.54mm_Vertical
R5, R6, R7, R8, R9, R10: 10k; R_Axial_DIN0204_L3.6mm_D1.6mm_P2.54mm_Vertical
R11, R12: 1k; R_Axial_DIN0204_L3.6mm_D1.6mm_P2.54mm_Vertical
R13, R14: 2k; R_Axial_DIN0204_L3.6mm_D1.6mm_P2.54mm_Vertical
U1: ESP32 DevKitC 38p; ESP32_DevKitC_38p
U2: MT3608 5,0V; MT3608_modulo
U3: GY-BMI160; GY_BMI160
U4: GY-BMP280; GY_BMP280

Connections:
+3V3: J3.1 (VCC), J4.1 (VCC), U1.1 (3V3), U3.2 (3V3), U3.6 (CS), U3.7 (SAO), U4.1 (VCC), U4.5 (CSB)
+5V: C2.1 (+), J2.6 (VCC), U1.19 (5V), U2.3 (OUT+)
DRENO_FL: C6.2, D4.2 (A), M4.2 (-), Q4.3 (D)
DRENO_FR: C3.2, D1.2 (A), M1.2 (-), Q1.3 (D)
DRENO_RL: C5.2, D3.2 (A), M3.2 (-), Q3.3 (D)
DRENO_RR: C4.2, D2.2 (A), M2.2 (-), Q2.3 (D)
ECHO_B: R11.1, R13.1, U1.11 (IO27)
ECHO_B5: J2.2 (ECHO_B), R11.2
ECHO_F: R12.1, R14.1, U1.13 (IO12)
ECHO_F5: J2.4 (ECHO_F), R12.2
FLOW_CS: J4.5 (CS), U1.10 (IO26)
FLOW_MISO: J4.2 (MISO), U1.7 (IO32)
FLOW_MOSI: J4.6 (MOSI), U1.9 (IO25)
FLOW_SCK: J4.4 (SCK), U1.8 (IO33)
GND: C1.2 (-), C2.2 (-), J1.2 (-), J2.1 (GND), J3.4 (GND), J4.3 (GND), Q1.2 (S), Q2.2 (S), Q3.2 (S), Q4.2 (S), R5.2, R6.2, R7.2, R8.2, R10.2, R13.2, R14.2, U1.14 (GND), U1.20 (GND), U1.26 (GND), U2.2 (IN-), U2.4 (OUT-), U3.3 (GND), U4.2 (GND), U4.6 (SDO)
IR_D: J3.3 (OUT_D), U1.4 (VN)
IR_E: J3.2 (OUT_E), U1.3 (VP)
M_FL: R4.2, U1.27 (IO19)
M_FR: R1.2, U1.30 (IO17)
M_RL: R3.2, U1.21 (IO23)
M_RR: R2.2, U1.32 (IO4)
PORTA_FL: Q4.1 (G), R4.1, R8.1
PORTA_FR: Q1.1 (G), R1.1, R5.1
PORTA_RL: Q3.1 (G), R3.1, R7.1
PORTA_RR: Q2.1 (G), R2.1, R6.1
SCL: U1.22 (IO22), U4.3 (SCL)
SCL2: U1.28 (IO18), U3.4 (SCL)
SDA: U1.25 (IO21), U4.4 (SDA)
SDA2: U1.31 (IO16), U3.5 (SDA)
TRIG_B: J2.3 (TRIG_B), U1.12 (IO14)
TRIG_F: J2.5 (TRIG_F), U1.15 (IO13)
VBAT: C1.1 (+), C3.1, C4.1, C5.1, C6.1, D1.1 (K), D2.1 (K), D3.1 (K), D4.1 (K), J1.1 (+), M1.1 (+), M2.1 (+), M3.1 (+), M4.1 (+), R9.1, U2.1 (IN+)
VBAT_ADC: R9.2, R10.1, U1.6 (IO35)

Notes on the sheet:
ALIMENTACAO
rabicho Molex da bateria: + na ilha quadrada (de fora)
IN+ IN- OUT+ OUT- | ajuste 5,0 V ANTES de encaixar o ESP32
CONTROLE (ESP32) E SENSORES DE BORDO
VIN 3V3 GND SCL SDA CS SAO | VIN solto; CS e SAO no 3V3 -> 0x69
VCC GND SCL SDA CSB SDO | CSB no 3V3 (I2C), SDO no GND -> 0x76
SONAR, IR E FLUXO OPTICO
1 GND 2 ECHO baixo 3 TRIG baixo 4 ECHO frente 5 TRIG frente 6 VCC(5V)
1 VCC(3V3) 2 OUT esq 3 OUT dir 4 GND
cima: MISO SCK MOSI | baixo: 3V3 GND CS | ligue com o drone DESLIGADO
MOTOR FR
1 = + (vermelho), 2 = - (preto/azul)
MOTOR RR
MOTOR RL
MOTOR FL
Placa de FACE UNICA: cobre so embaixo. Jumpers = fio por cima.
Mesmo nome de etiqueta = mesma ligacao. Pinos conforme include/board_esp32.h.
Trilhas: 2,5 mm (VBAT, drenos) / 1,5 mm (GND, 5V, 3V3) / 1,2 mm (sinais). Folga 0,8 mm.

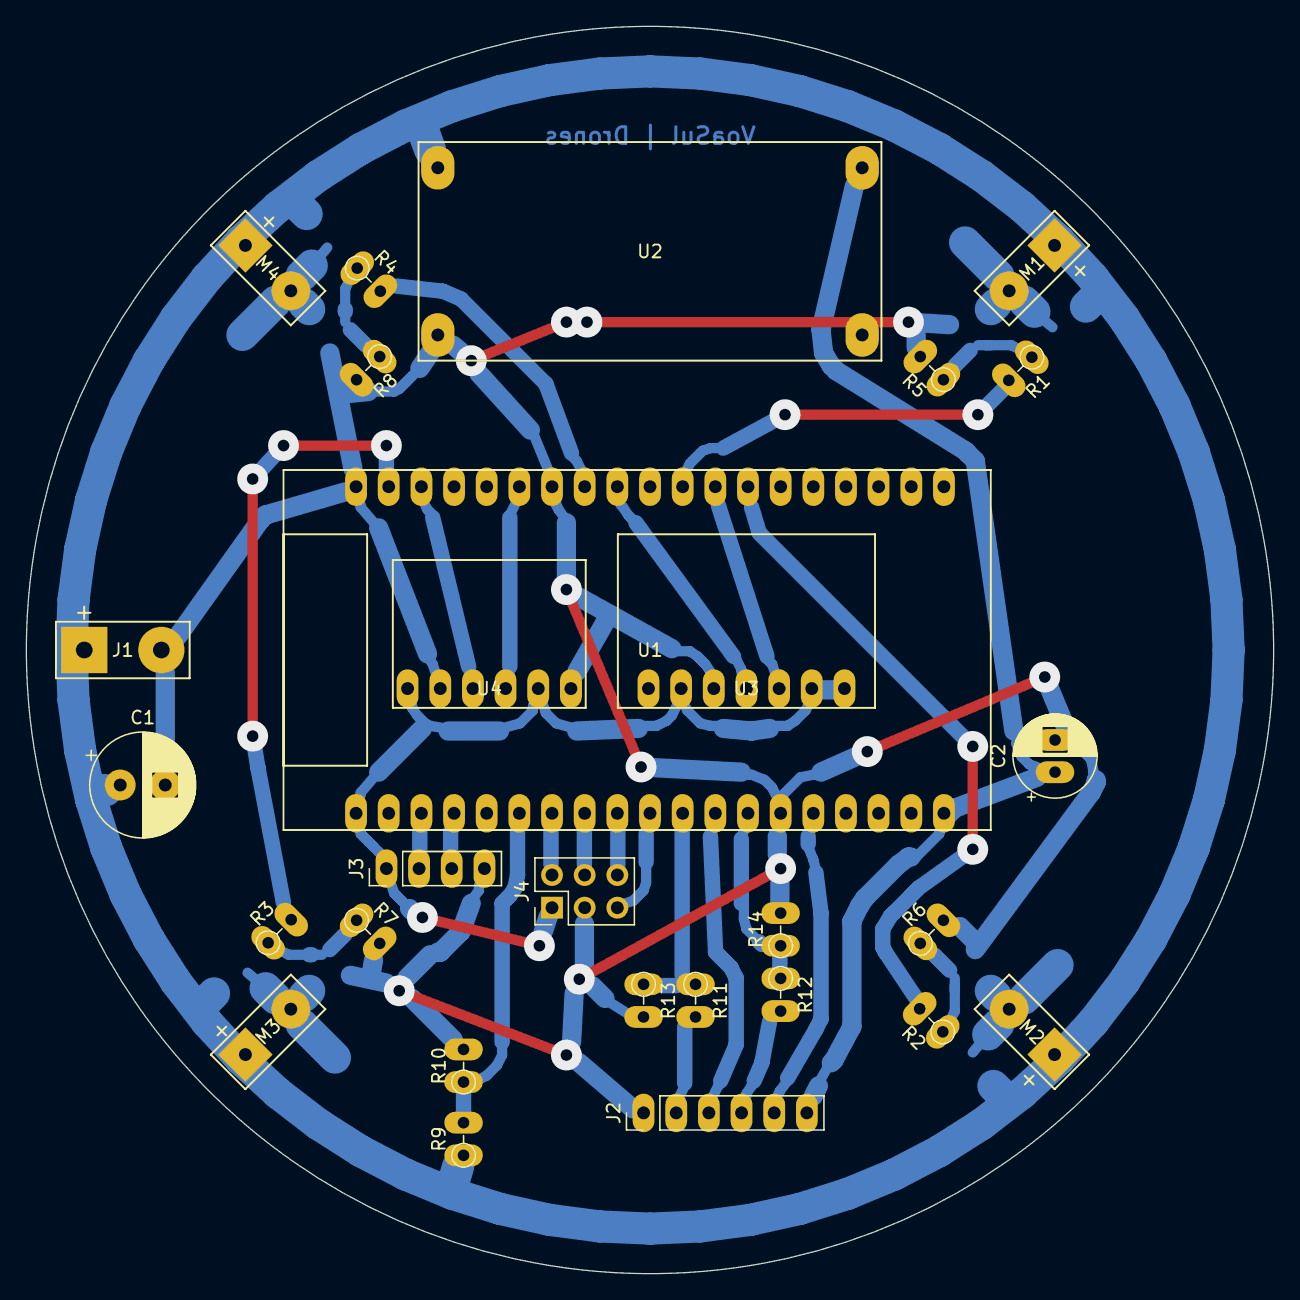
[picture p44: board drone.kicad_pcb from above]

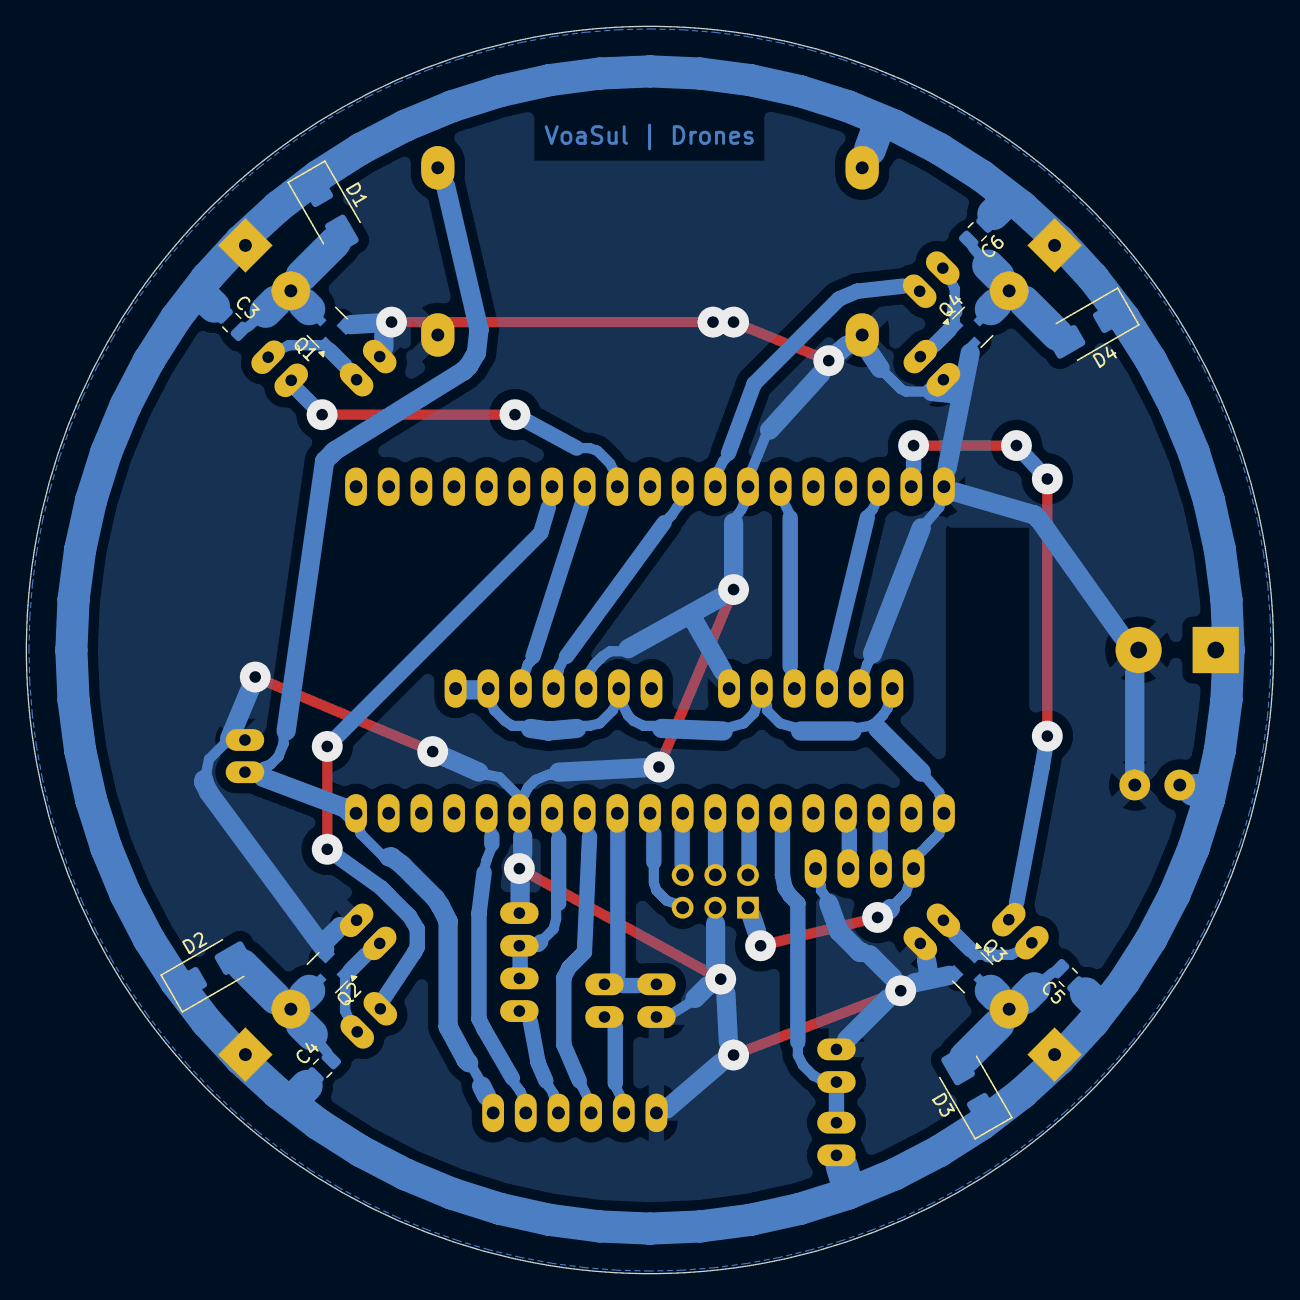
[picture p45: board drone.kicad_pcb from below]

Board: 2 copper layers, 97.0 x 97.0 mm, 40 parts (12 on the bottom side), 33 nets.
