EduGomesNascimento/VOASUL/(commit log)

2026-08-17 Cria o site institucional da VOA-SUL
    Site estático (HTML/CSS/JS, sem build) com o conteúdo derivado do Plano
    Mercadológico e do Plano de Marketing da empresa.
    Páginas:
    - index: posicionamento, compromissos de produto, diferenciais, linhas e
    fluxo do pedido ao primeiro voo
    - produtos: as quatro linhas (FPV 5", recreativo até 250 g, kits e peças
    em impressão 3D, reparo e upgrade)
    - homologacao: ANATEL x ANAC, o risco do importado sem homologação,
    passo a passo do cadastro e FAQ
    - sobre: a empresa, o mercado, forma de trabalho e a marca
    - orcamento: formulário com validação no cliente e pré-seleção por URL
    - contato: canais de atendimento
    Identidade visual a partir dos SV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
2026-08-17 Atualiza o e-mail de contato para sulvoa@gmail.com
2026-08-17 Ícone quadrado da marca e animações no site
    Favicon: o arquivo anterior usava o símbolo inteiro, de proporção
    928x388, que na aba do navegador encolhia até ficar ilegível. Agora um
    SVG quadrado de 512px recorta a região do "V", em branco sobre o
    azul-marinho da marca. Verificado de 16px a 128px.
    Animações:
    - botões com elevação, sombra colorida, brilho que atravessa no hover e
    recuo ao clicar
    - cabeçalho compacta e ganha sombra ao rolar; traço cresce sob o item do
    menu; as barras do menu mobile viram um X
    - entrada escalonada do hero, com o símbolo revelado da esquerda para a
    direita e flutuação contínua
    - cartões, passos, ícones e linhas da tabela reagem ao pont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
2026-09-29 Adiciona o VOA-SUL ERP: controle de estoque e demandas
    Aplicação Python que sobe um servidor local e abre no navegador. Usa
    apenas a biblioteca padrão (sqlite3, wsgiref, hashlib, csv) — sem pip e
    sem internet, para que o instalador .bat replique a instalação em
    qualquer PC com Python.
    Módulos: painel com indicadores, pedidos de venda e compra, demandas de
    produção e compra, movimentação de estoque com custo médio, cadastro de
    itens e de clientes/fornecedores, notas fiscais, números de série com
    ficha de inspeção, etiquetas com código de barras e seis relatórios com
    exportação em CSV.
    Regras de estoque: o pedido baixa o estoque a partir de "confirmado" e
    estorna com mov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
2026-09-29 Garante quebra de linha do Windows nos arquivos .bat
    Sem isso o git entrega os arquivos de lote com LF em um checkout no
    Windows, e o interpretador de comandos pode falhar nos blocos com
    parênteses e nos rótulos do instalador.
    Claude-Session: https://claude.ai/code/session_01R8Lu3w54AMxYLC9QY4NT4J
2026-11-03 Adiciona o projeto do drone: placa KiCad de face unica, firmware e docs
    - drone/: firmware (ESP32/Pico W), frame impresso, docs e a placa antiga do Proteus
    - drone/kicad/: esquema e placa gerados por script a partir de projeto.py, com
    roteador proprio para face unica (trilhas 2,5/1,5/1,2 mm, folga 0,8 mm),
    PDF de transferencia, lista de jumpers, visualizador 3D e versao
    profissional (2 camadas) com Gerber
    - firmware: nova pinagem da placa (motores 17/4/23/19, BMI160 em barramento
    I2C proprio 16/18, bateria no IO35) e driver do BMI160 com barramento
    configuravel
    - docs: plano de montagem com requisitos e testes por fase, luva de gestos,
    conferencia completa (inclui a pegada espelh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
2026-11-04 Adiciona molde 1:1 do frame do drone em compensado
    Alternativa ao frame de PLA: braco A inteiro, braco B em duas metades e
    duas placas de centro (O36), chapa de 3 mm, ~12 g contra ~28 g do PLA.
    Mesmas medidas (motores a 100,4 mm do centro). Pagina 2 traz a montagem.
    Claude-Session: https://claude.ai/code/session_01ABXN8qSP8LKu7uAquUJxQX
2026-11-04 Adiciona resumo em PDF do que falta fazer e comprar (abas)
    Resumo, Comprar (com links), Fazer (12 etapas com criterio de pronto),
    Decidir e Bancada. O HTML fonte fica ao lado do PDF.
    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
2026-11-04 Adiciona folha de transferencia A4 com duas copias 1:1 da placa
    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
2026-11-04 Adiciona folha de montagem clara (cima, baixo e lista de pecas)
    Desenhada a partir da placa do KiCad: pecas com valor, pino 1, polaridade,
    jumpers numerados como no jumpers.txt, vista por baixo com G/S/D dos
    MOSFETs e catodo dos diodos, detalhe ampliado de um canto, ordem de
    montagem e o que nao esta na folha de cobre.
    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
2026-11-05 Fluxo optico PMW3901 opcional: firmware, testes e fontes da placa
    Firmware (voa com e sem o modulo):
    - include/opticalflow.h + src/opticalflow.cpp: driver SPI do PMW3901
    (sequencia de registradores da Bitcraze), estimador de velocidade com
    desconto da inclinacao pelo giroscopio e freio de deriva com o manche solto.
    - Deteccao no boot pelo ID do chip (0x49) e pelo inverso (0xB6); o ID e
    conferido em voo e um fio solto vira 'ausente' em ate 3 leituras.
    - Telemetria fl/vf/vr/sq e quadro 'Fluxo' na pagina do celular.
    - Testes no PC: conta da velocidade, sinais, lixo de fio solto, freio e
    driver contra um sensor simulado (test/flowhw.cpp).
    Pinos novos (board_esp32.h = projeto.py): fluxo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
2026-11-05 Placa: sonar reposicionado e ordem de roteamento sem bloqueio
    R14/R12 (ECHO da frente) em coluna logo abaixo do GND do ESP32, J4 e o
    divisor do ECHO de baixo um pouco para a esquerda, sonar roteado antes dos
    motores e o 5V do J2 ligado depois do sonar (+5V:adiado). No teste sem
    jumpers sonar e fluxo optico fecham sem cruzamento.
    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
2026-11-05 Roteador: jumpers de ate 25 mm e busca maior com jumper
    O GND do canto de tras a esquerda precisa saltar por cima das trilhas do
    sonar, do fluxo optico e do divisor da bateria de uma vez (~25 mm).
    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
2026-11-05 Roteamento: M_RR antes do sonar e GND antes do 3V3 do J4
    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
2026-11-05 Placa: J4 compacto 2x3 e jumpers fixos de GND/3V3
    - J4 (fluxo optico) vira barra 2x3 logo abaixo dos pinos 32/33/25/26:
    trilhas curtas e a parte de tras da placa livre para o GND.
    - Jumpers posicionados a mao (projeto.JUMPERS_FIXOS) que o roteador nao
    achava sozinho: GND do pino 14 do ESP32 ao centro de tras, do centro ao
    canto de tras-esquerda (motor RL), e 3V3 do J3 ao J4.
    - Roteador: jumpers fixos como fios (grupos ligados tambem na fase de
    potencia) e nova tentativa para pino de potencia que falhou.
    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
2026-11-05 Roteador: GND nasce na bateria (J1.2)
    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
2026-11-05 Roteamento: sinal do motor RL depois do GND
    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
2026-11-05 Placa nova com o conector do fluxo optico (J4): roteada, conferida e saidas
    - Roteamento: 0 falhas, 11 jumpers (antes 14): 6 de GND, 1 de 3V3, 4 de sinal.
    - DRC da placa caseira e da profissional: 0 erros e 0 pinos desligados
    (o GND agora fecha todo pelo cobre, inclusive o do pino 26 do ESP32).
    - Esquema x placa: 0 diferencas (33 redes, 126 pinos).
    - Novas: folha de transferencia A4 (escala conferida: disco 97,0 mm, regua
    100,0 mm), folha de montagem (J4 2x3, J2 na ordem nova), esquema em PDF,
    imagens 3D, Gerber da profissional.
    - folha_transferencia.py no repositorio e no gerar_tudo.sh; modelo 3D da
    barra 2x3; visualizador 3D com charset utf-8.
    - Docs: README, CONFERENCIA e pendenci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
2026-11-05 Pedido da placa na JLCPCB: Gerber enxuto, guia e listas sem a placa caseira
    - kicad/pro/drone_VoaSul_JLCPCB.zip: so cobre, mascara, serigrafia, contorno
    e furos (gerado tambem pelo 'gerar.py profissional').
    - kicad/pro/PEDIDO_JLCPCB.md: especificacoes do formulario, conferencia da
    placa (2 camadas, 97 x 97 mm, trilha min. 0,8, via 0,5), custo e prazo
    estimados, pecas para soldar e o que saiu da lista.
    - Pendencias e plano de montagem: placa da JLCPCB no lugar da transferencia
    termica (sai papel, fenolite, palha de aco, percloreto, brocas e jumpers).
    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
2026-11-09 BOM, arquivos de montagem da JLCPCB e prompt do carrinho
    - kicad/bom.py: BOM completa (saidas/BOM.csv) e, para a montagem opcional
    das 12 pecas SMD da face de baixo, BOM_JLCPCB.csv (codigos LCSC C20917,
    C8678, C49678, conferidos na LCSC) e CPL_JLCPCB.csv (posicao e giro).
    - kicad/pro/PROMPT_CARRINHO_JLCPCB.md: prompt para o Claude no navegador
    configurar o pedido e salvar no carrinho, sem pagar (so placa, ou placa
    com montagem SMD).
    - PEDIDO_JLCPCB.md: BOM, opcao de montagem e prazo atualizado.
    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
2026-11-09 Placa caseira para CNC: G-code de isolamento, furos e contorno
    - kicad/cnc.py: le o cobre de baixo da placa (trilhas, ilhas, vias dos
    jumpers e plano de GND) e gera G-code GRBL espelhado (cobre para cima,
    origem no centro do disco): isolamento com fresa em V (2 passadas, sem
    entrar no cobre vizinho; conferido por geometria), furos por broca
    (0,9 / 1,0 / 1,3 e alternativa so com 1,0), limpeza opcional embaixo da
    antena do ESP32 e contorno de 97 mm com 4 pontes. Mais a previa em PNG.
    - kicad/cnc/README_CNC.md: ordem, origem, autolevel e valores.
    - Pendencias, plano de montagem e guia da JLCPCB: placa fresada na CNC
    agora (volta a fenolite, entram as fresas); JLCPCB fica opcional.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
2026-11-09 Versao de usinagem da placa nas regras da CNC do amigo
    Regras: folga >= 0,5 mm, trilha >= 0,6 mm, furo >= 0,8 mm, ilha >= 1,8 mm.
    - gerar.py usinagem: a mesma placa caseira (sem rotear de novo), com as 97
    ilhas de pino aumentadas para 1,9-2,0 mm (anel >= 0,5 mm) e sem o texto
    fino no cobre. DRC com essas regras: 0 erros, 0 pinos desligados; menor
    distancia entre cobres 0,54 mm.
    - usinagem/: Gerber (B.Cu, F.Cu so com os 11 jumpers, contorno), furacao
    Excellon unica, mapa de furos, previas em PDF, LEIA-ME e dois zips (face
    unica, recomendado; dupla face).
    - cnc.py passa a usar essa versao; G-code regerado.
    Claude-Session: https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
2026-11-10 CNC: placa virgem de 110 x 110 mm ou maior
    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
2026-11-10 Luva simples de 1 sensor controlando o drone (ESP-NOW) e escopo minimo
    Luva (luva/, XIAO ESP32-S3 + 1 MPU-6050):
    - gestos.h: mao reta = parado; inclinar = andar; girar deitada = girar;
    dedos para cima/baixo = subir/descer (com histerese); palma para cima
    segurada 0,5 s = pousar. Filtro complementar. 18 testes no PC (luva/test).
    - main.cpp: calibra a mao reta ao ligar, BOOT segurado 1,5 s arma e qualquer
    toque desarma; manda o mesmo pacote 'C,...' do celular por ESP-NOW a 50 Hz
    com o prefixo VS1:, alt-hold sempre ligado.
    Drone:
    - AP em canal fixo (WIFI_CHANNEL 1); recebe a luva por ESP-NOW; enquanto a
    luva manda, o celular so assiste; bit 8 = pousar; quadro 'Luva' na pagina.
    Compila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
2026-11-10 Luva no ESP32-C3 Super Mini (o mais barato); perfis c3, c6 e xiao
    - luva/platformio.ini: perfis c3 (padrao), c6 e xiao, cada um com os seus
    pinos (C3/C6: SDA 6, SCL 7, BOOT 9; nao usa o 8, que e o LED). Os tres
    compilam.
    - Guia, pendencias e contexto: C3 Super Mini (~R$ 11) e MPU-6050 (~R$ 7)
    na AliExpress; drone com GY-BMI160 + GY-BMP280-3.3.
    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
2026-11-10 BOM total da versao minima (drone + luva), com o que ja tem e o mais barato
    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
2026-11-10 So o app no celular: sem luva e sem joystick
    - Remove a luva (luva/) e a recepcao ESP-NOW do drone.
    - Pagina do celular: ALT HOLD ligado por padrao (o manche esquerdo volta ao
    centro = mantem a altura; throttle 0 ao armar), botao POUSAR (bit 8),
    sem os quadros de desvio, solo, frente, IR e fluxo.
    - Pouso automatico sem sonar usa o barometro (desce a 0,35 m/s, ate 10 s)
    em vez de cortar a potencia as cegas.
    - BOM total, pendencias, plano, contexto e lista de compras sem a luva.
    Total: R$ 81,70 + energia (bateria R$ 90,91 ou cabo R$ 9,00).
    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
2026-11-10 Estacao terra: ESP32-C3 na capinha do celular, ESP-NOW ate o drone
    - src/terra/terra.cpp (perfil 'terra', ESP32-C3 Super Mini): cria a rede
    VOASUL-TERRA, serve a mesma pagina, repassa cada comando ao drone por
    ESP-NOW (VS1:, broadcast ate ouvir o drone, depois direto no MAC dele) e
    devolve a telemetria (VT1:) e o estado do enlace ao celular.
    - Drone: recebe os comandos da terra (enquanto ela manda, o celular direto so
    assiste) e manda a telemetria de volta (JSON enxuto, < 250 bytes). Rede
    propria renomeada para VOASUL-DRONE (reserva).
    - platform.h: leitura de GPIO que compila tambem no C3.
    - Pagina: mostra 'terra + drone ok' / 'SEM SINAL DO DRONE'.
    - docs/TERRA.md; BOM (+ C3 e cabo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
2026-11-10 BOM: Molex 51005 ja comprado (5 pares)
    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
2026-11-10 BOM: volta o Molex 51005 para comprar (o JST SM nao encaixa na bateria)
    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
2026-11-10 Placa feita em casa por transferencia termica + percloreto (CNC vira alternativa)
    - PLANO_DE_MONTAGEM fase 3: transferencia como caminho principal, papel transfer,
    folha A4 com duas copias, sem espelhar
    - BOM: grupo 'Placa: fabricar' (papel transfer, percloreto, caneta, brocas)
    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
